farzonl/gtnr/README.md

# The Repo of the Georgia Tech Night Rover Project
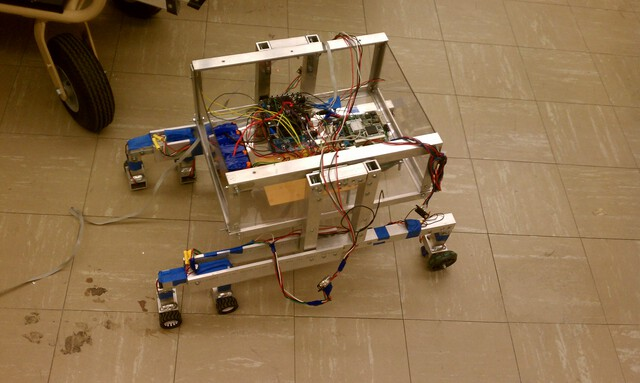
[picture p1: Documentation/SharedImages/IMAG1715.jpg]

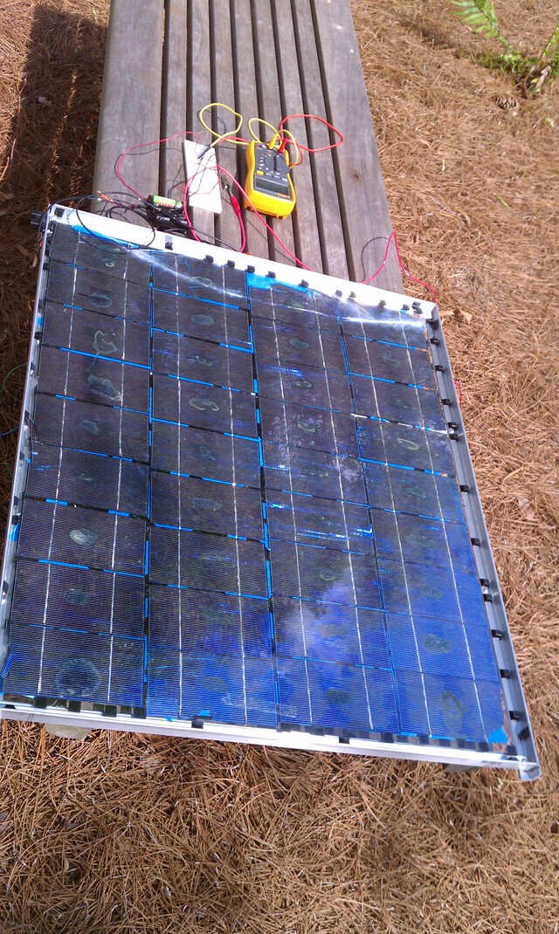
[picture p2: Documentation/SharedImages/IMAG1690.jpg]


## Proposal:
<object data="https://raw.githubusercontent.com/farzonl/gtnr/master/Documentation/Proposals/GT_NightRover-CornellCupApplication_v2.pdf" type="application/pdf" width="700px" height="700px">
    <p>Github does not support embedded PDFs. <a href="https://raw.githubusercontent.com/farzonl/gtnr/master/Documentation/Proposals/GT_NightRover-CornellCupApplication_v2.pdf"> Click here to view</a>.</p>
</object>

## Solar Panel Monte Carlo Simulations
### Power Output Distribution
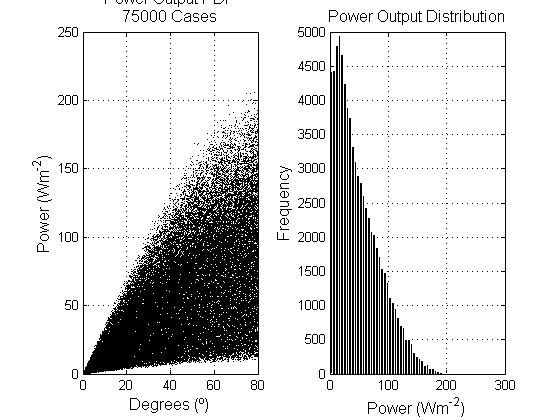
[picture p3: MATLAB/SolarPanelMonteCarlo/PowerOutputDistribution.png]

### Power Output (PDF & CDF)
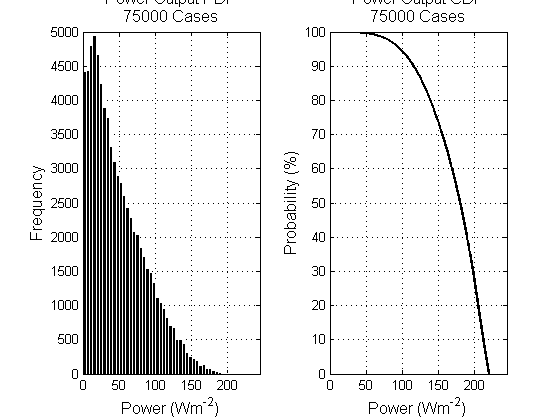
[picture p4: MATLAB/SolarPanelMonteCarlo/PowerOutputPDFCDF.png]

### Random Variable Distribution
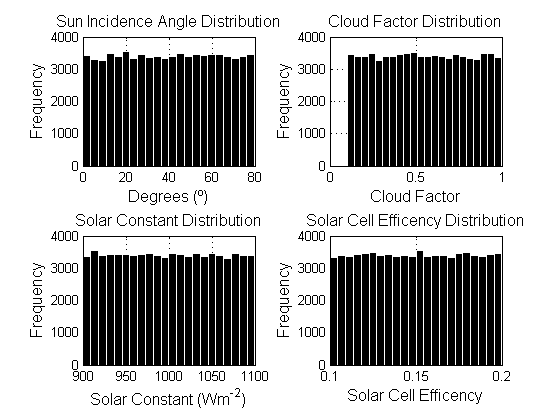
[picture p5: MATLAB/SolarPanelMonteCarlo/RandomVariableDistribution-1.png]

### Random Variable Distribution 2
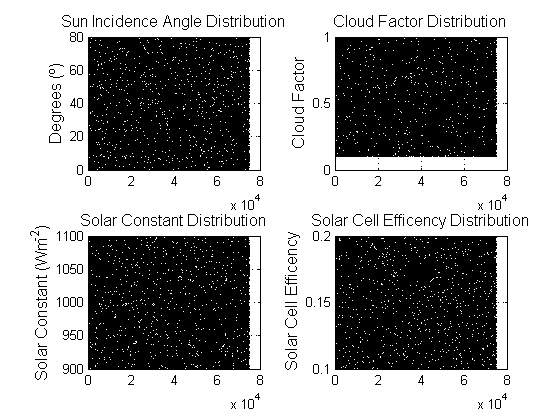
[picture p6: MATLAB/SolarPanelMonteCarlo/RandomVariableDistribution-2.png]


## Electrical Overview
### Schematic
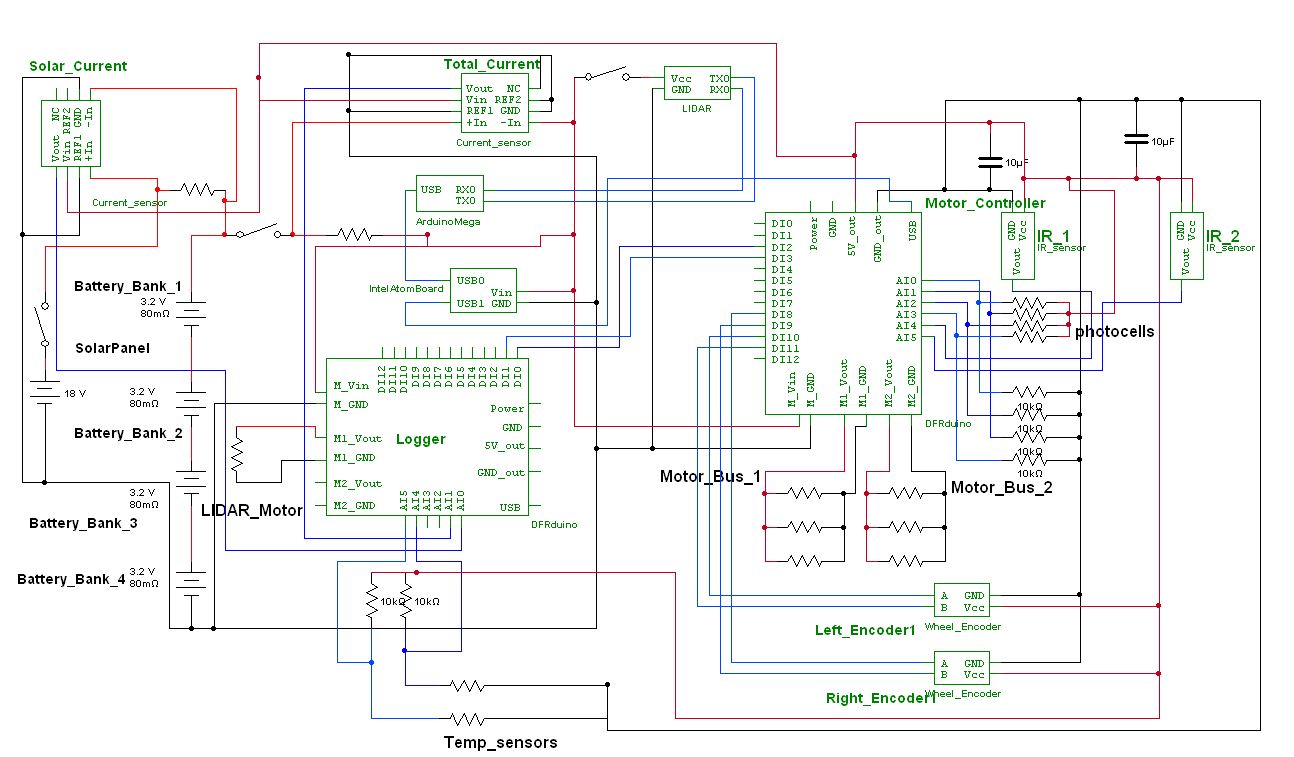
[picture p7: Documentation/FinalReport/schematic4.JPG]


## Software Overview
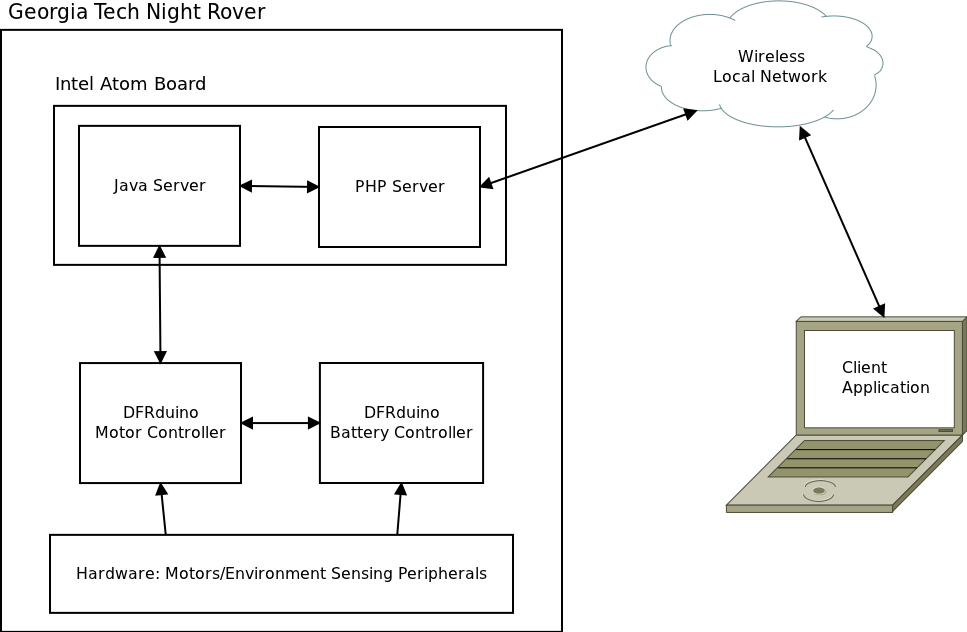
[picture p8: Documentation/FinalReport/SoftwareArchitecture/SoftwareOverview.png]

### Website
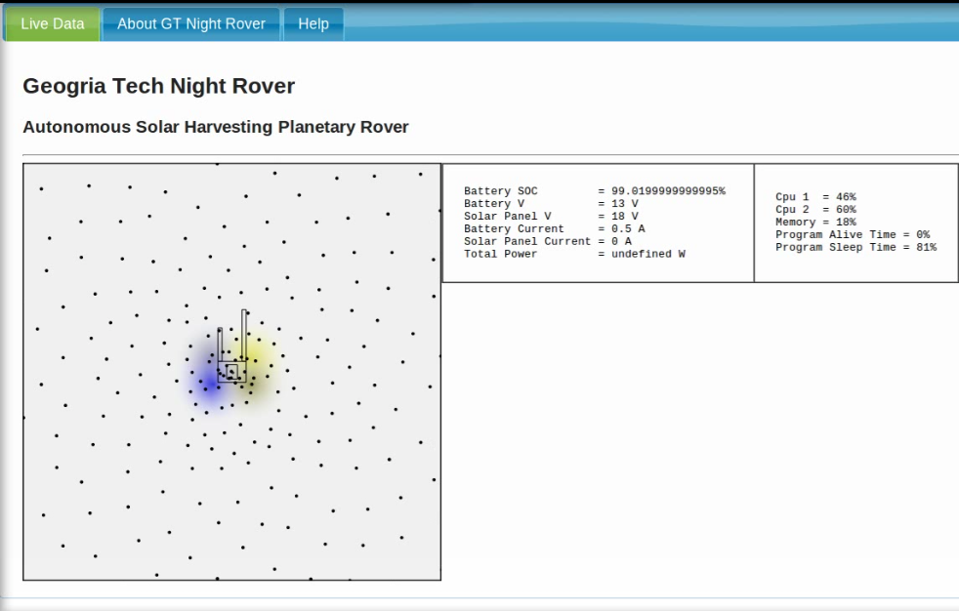
[picture p9: Documentation/FinalReport/GTNR_site.png]

### UML (Overview)
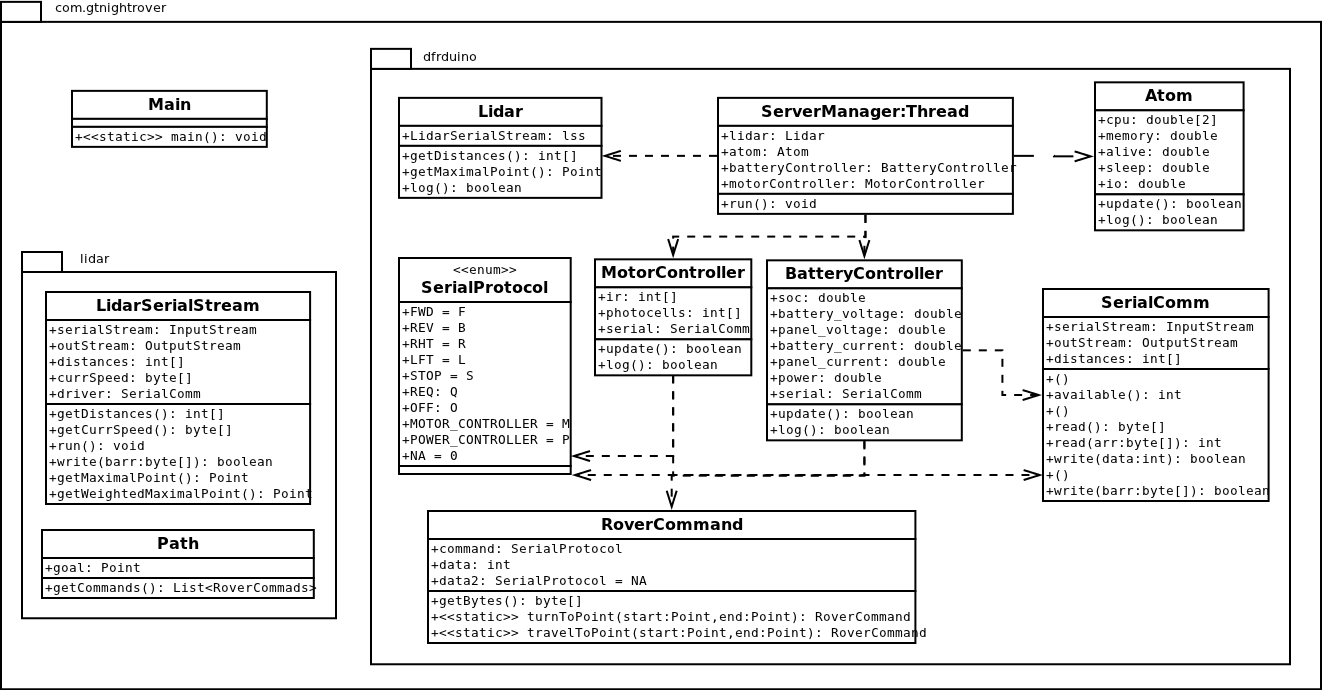
[picture p10: Documentation/FinalReport/SoftwareArchitecture/GTNR_UML.png]

### UML (deep dive)
#### lidar
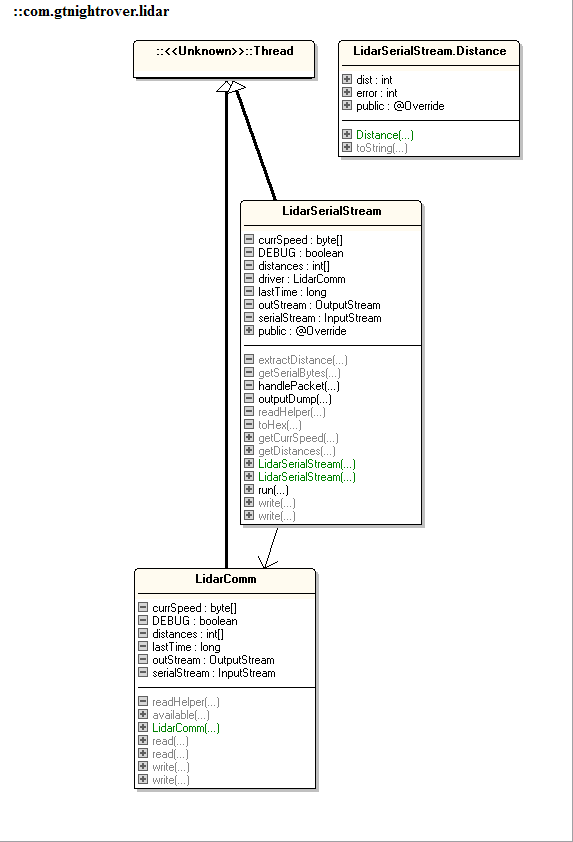
[picture p11: Documentation/FinalReport/SoftwareArchitecture/lidar.png]

#### log
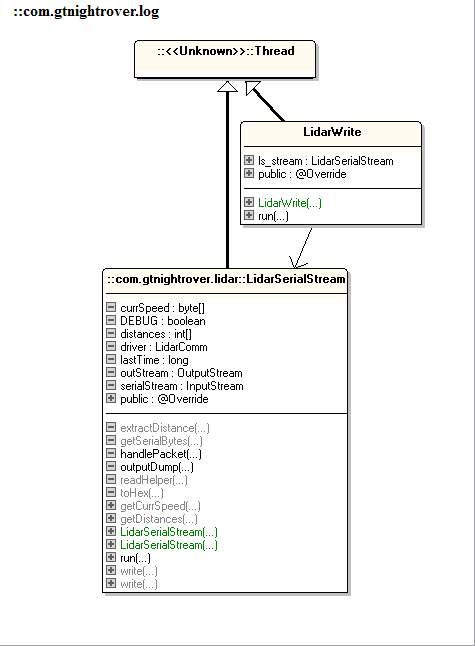
[picture p12: Documentation/FinalReport/SoftwareArchitecture/log.png]

#### Networking
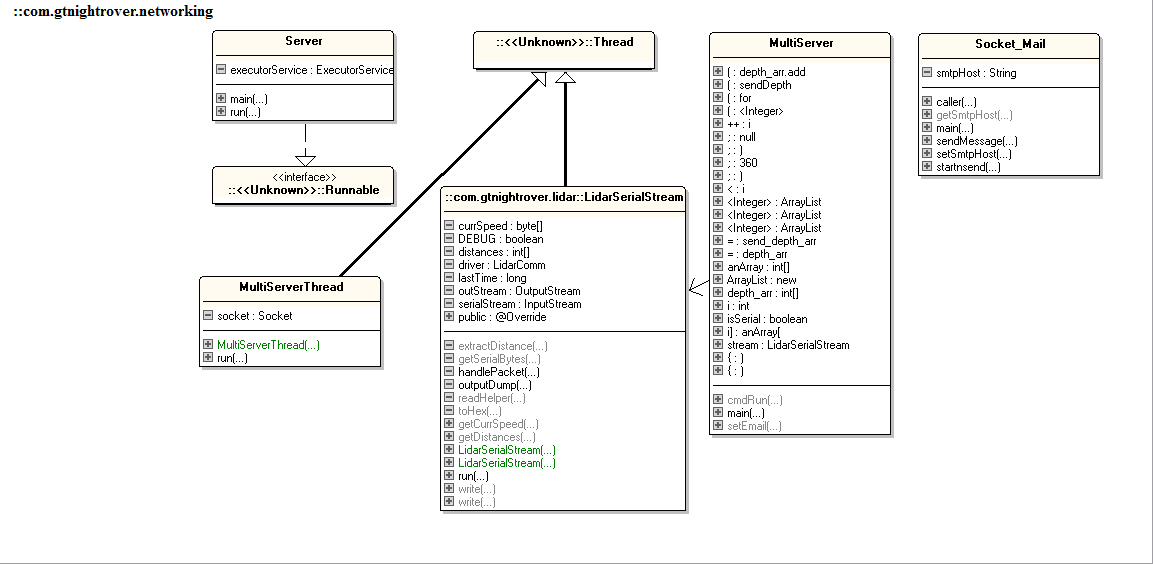
[picture p13: Documentation/FinalReport/SoftwareArchitecture/Networking.png]

#### Serial
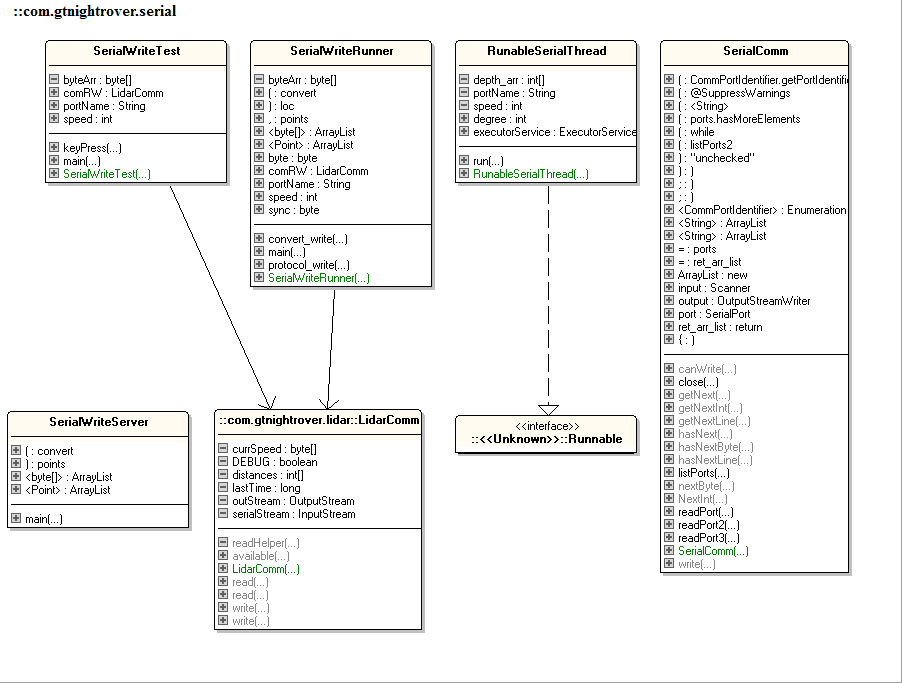
[picture p14: Documentation/FinalReport/SoftwareArchitecture/Serial.png]

#### Graph Search
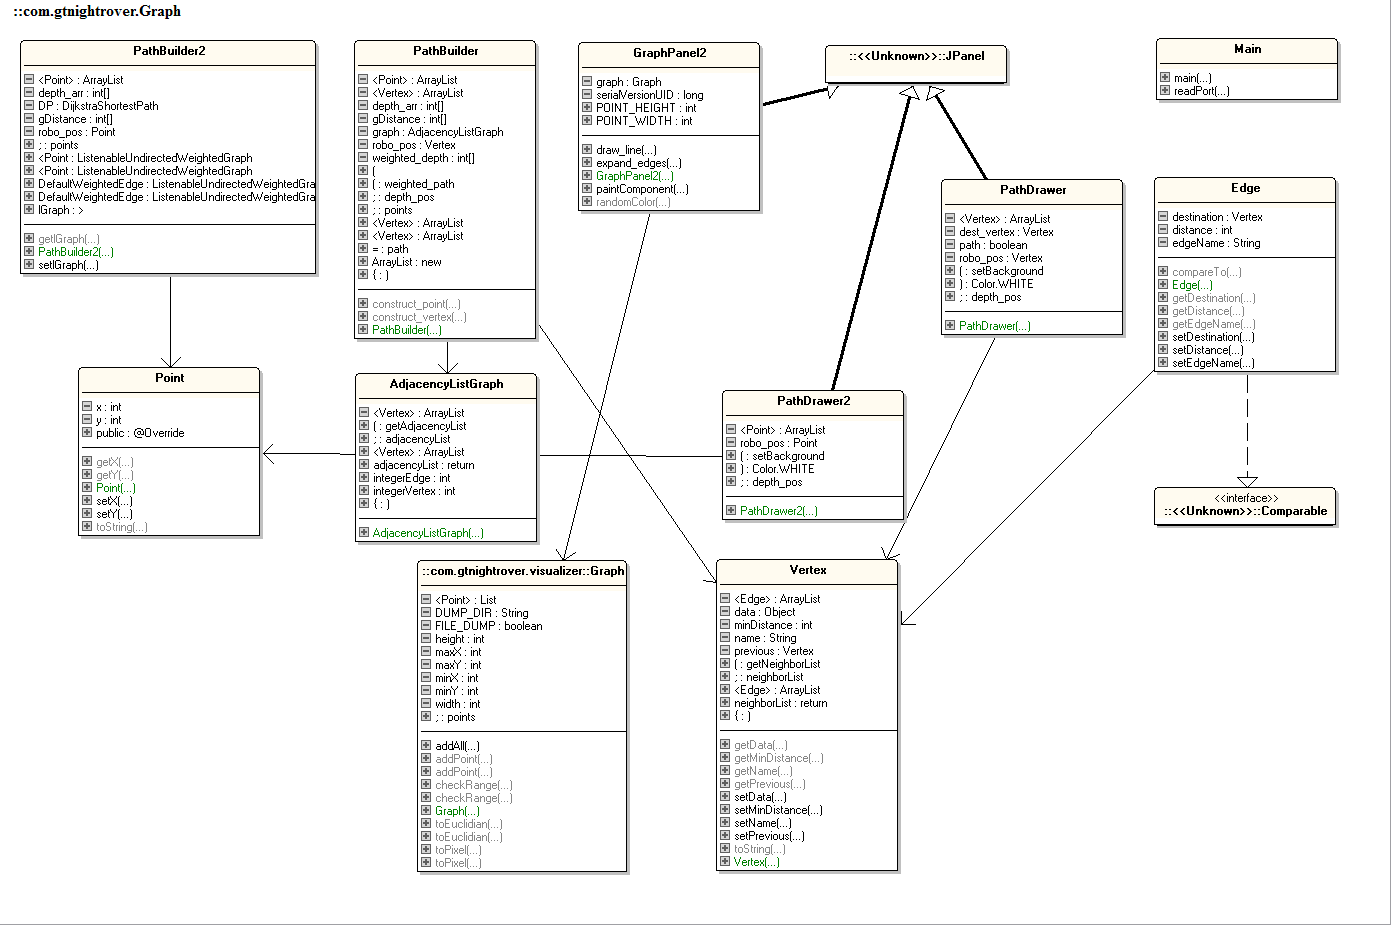
[picture p15: Documentation/FinalReport/SoftwareArchitecture/graph.png]


## Mechanical Overview
<object data="https://raw.githubusercontent.com/farzonl/gtnr/master/Documentation/FinalReport/StructureCAD/rockerDrawings.PDF" type="application/pdf" width="700px" height="700px">
    <p>Github does not support embedded PDFs. <a href="https://raw.githubusercontent.com/farzonl/gtnr/master/Documentation/FinalReport/StructureCAD/rockerDrawings.PDF"> Click here to view</a>.</p>
</object>

## Lidar demonstration:
- https://youtu.be/Fa6pLtnfDQM
- https://youtu.be/SGN1jOzPnew

## Presentations
### Midterm Review
<object data="https://raw.githubusercontent.com/farzonl/gtnr/master/Documentation/Presentations/GTNR_MidTermReview2.pdf" type="application/pdf" width="700px" height="700px">
    <p>Github does not support embedded PDFs. <a href="https://raw.githubusercontent.com/farzonl/gtnr/master/Documentation/Presentations/GTNR_MidTermReview2.pdf"> Click here to view</a>.</p>
</object>

### Final Review
<object data="https://raw.githubusercontent.com/farzonl/gtnr/master/Documentation/Presentations/GTNR_Final_Presentation.pdf" type="application/pdf" width="700px" height="700px">
    <p>Github does not support embedded PDFs. <a href="https://raw.githubusercontent.com/farzonl/gtnr/master/Documentation/Presentations/GTNR_Final_Presentation.pdf"> Click here to view</a>.</p>
</object>

## Final report:
<object data="https://raw.githubusercontent.com/farzonl/gtnr/master/Documentation/FinalReport/ICCFinalReport_2.pdf" type="application/pdf" width="700px" height="700px">
    <p>Github does not support embedded PDFs. <a href="https://raw.githubusercontent.com/farzonl/gtnr/master/Documentation/FinalReport/ICCFinalReport_2.pdf"> Click here to view</a>.</p>
</object>
