farzonl/gtnr/Documentation/FinalReport/StructureCAD/Mechanical/Lunar Rover Config 1.pptx

Solar Panel

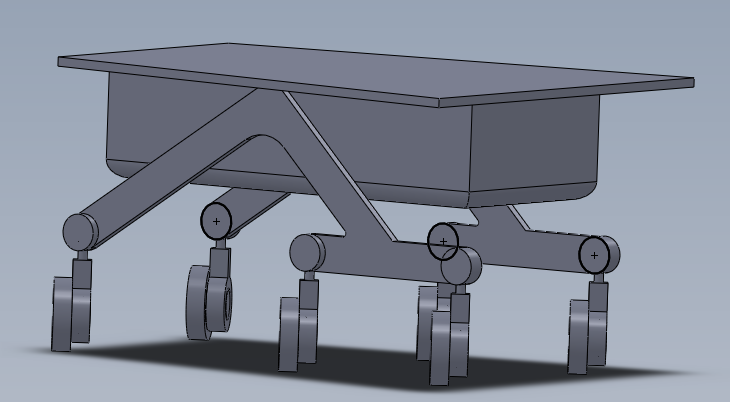
[picture p50: figure]

Body
(Houses avonics)

Roller Bearing for pivoting joints
