farzonl/gtnr/Documentation/FinalReport/MotorCalculations.xls

Sheet: 0 Degrees
 | Posted Experimental Torque On Flat Ground
 |  |  |  | Torque (kgm^2/s^2)
These values are calculated using T=maL, where "m" is mass, "a" is acceleration (0.5m/s^2) and "L" is length. |  | Mass (kg) | Wheel Size (m) | needed | diff | provided | Force (kgm/s^2) | # Motors
 |  | 6 | 0.044 |  |  |  | 0.0706 | 6
 |  | 8 | 0.044 |  |  |  | 0.0706 | 6
 |  | 10 | 0.044 |  |  |  | 0.0706 | 6
 |  | 12 | 0.044 |  |  |  | 0.0706 | 6
 |  | 15 | 0.044 |  |  |  | 0.0706 | 6
 |  | 6 | 0.044 |  |  |  | 0.0706 | 8
 |  | 8 | 0.044 |  |  |  | 0.0706 | 8
 |  | 10 | 0.044 |  |  |  | 0.0706 | 8
 |  | 12 | 0.044 |  |  |  | 0.0706 | 8
 |  | 15 | 0.044 |  |  |  | 0.0706 | 8
 |  | 20 | 0.044 |  |  |  | 0.0706 | 8
 |  | 6 | 0.06 |  |  |  | 0.0706 | 6
 |  | 8 | 0.06 |  |  |  | 0.0706 | 6
 |  | 10 | 0.06 |  |  |  | 0.0706 | 6
 |  | 12 | 0.06 |  |  |  | 0.0706 | 6
 |  | 15 | 0.06 |  |  |  | 0.0706 | 6
 |  | 15 | 0.06 |  |  |  | 0.0706 | 6
 |  | 6 | 0.06 |  |  |  | 0.0706 | 8
 |  | 8 | 0.06 |  |  |  | 0.0706 | 8
 |  | 10 | 0.06 |  |  |  | 0.0706 | 8
 |  | 12 | 0.06 |  |  |  | 0.0706 | 8
 |  | 15 | 0.06 |  |  |  | 0.0706 | 8
 |  | 20 | 0.06 |  |  |  | 0.0706 | 8
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
