farzonl/gtnr/Documentation/FinalReport/Electrical/BatteryDesign/pic1.JPG

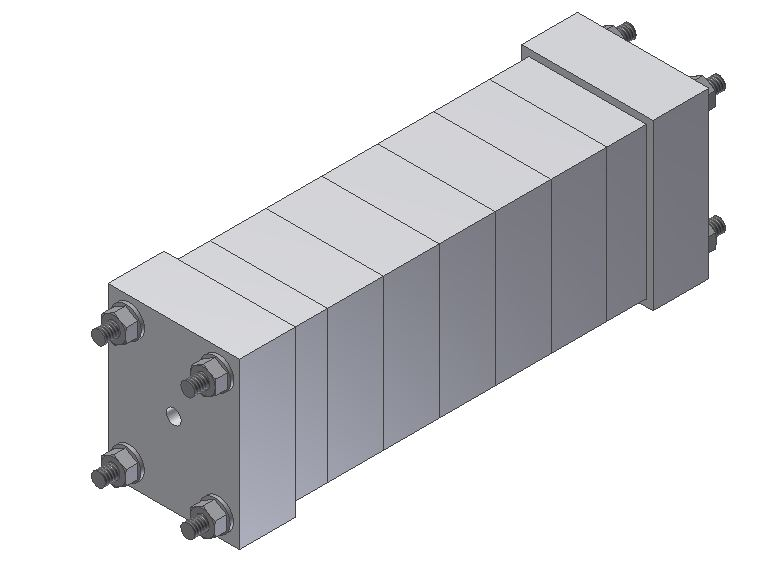
Documentation/FinalReport/Electrical/BatteryDesign/pic1.JPG
