farzonl/gtnr/Documentation/FinalReport/Electrical/BatteryDesign/pic2.JPG

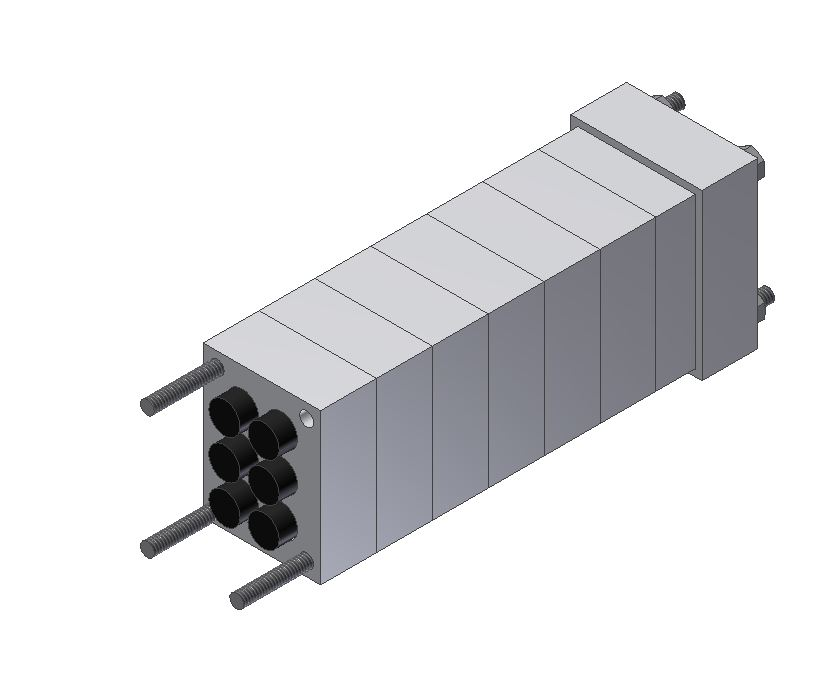
Documentation/FinalReport/Electrical/BatteryDesign/pic2.JPG
