farzonl/gtnr/Documentation/FinalReport/Electrical/BatteryDesign/pic3.JPG

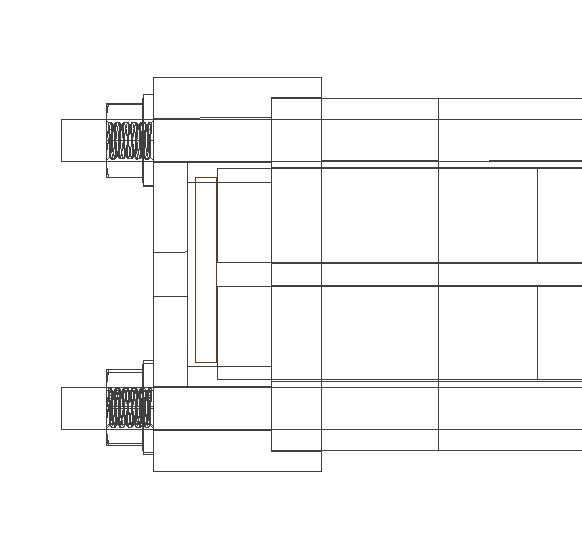
Documentation/FinalReport/Electrical/BatteryDesign/pic3.JPG
