farzonl/gtnr/Documentation/FinalReport/Electrical/BatteryDesign/pic4.JPG

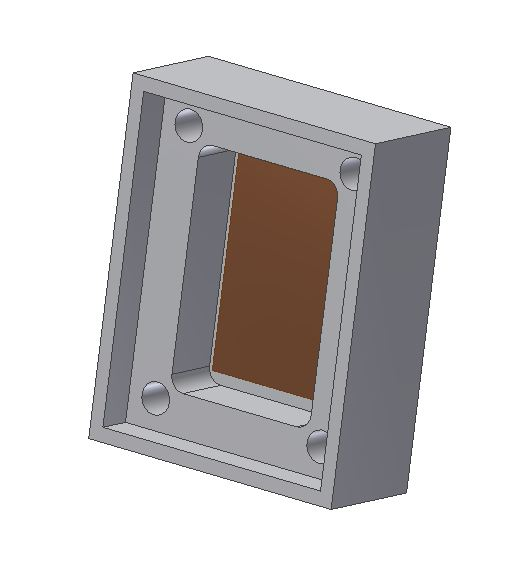
Documentation/FinalReport/Electrical/BatteryDesign/pic4.JPG
