farzonl/gtnr/Documentation/FinalReport/Electrical/SubsystemsDiagramv1.png

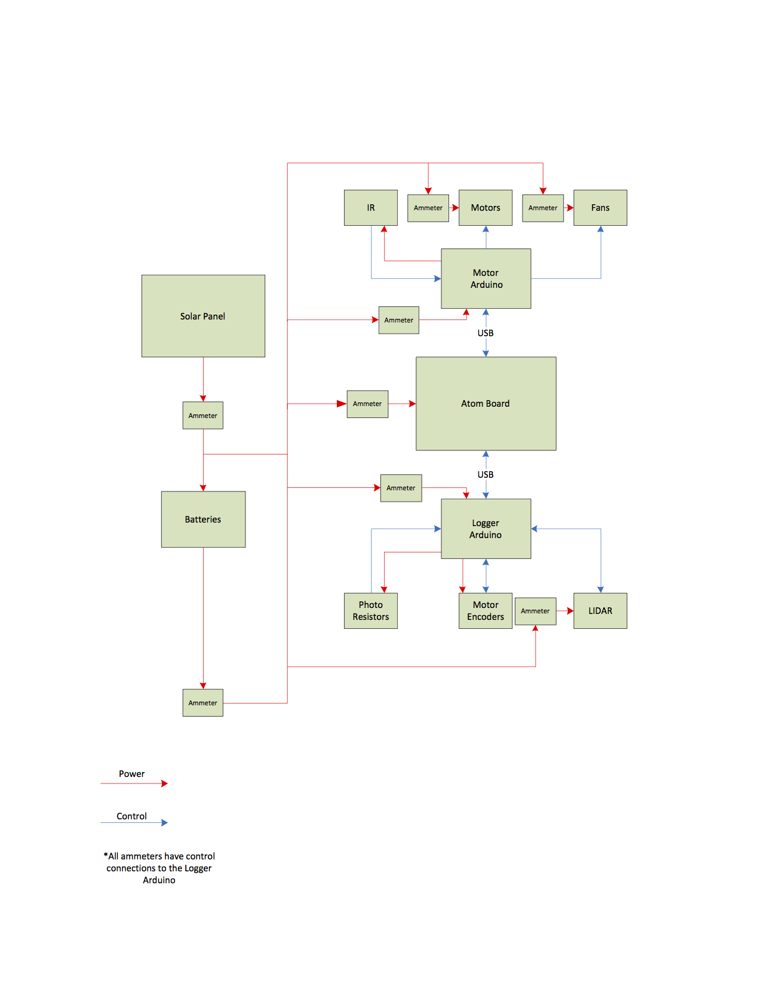
Documentation/FinalReport/Electrical/SubsystemsDiagramv1.png
