farzonl/gtnr/Documentation/FinalReport/SoftwareArchitecture/visualizer.png

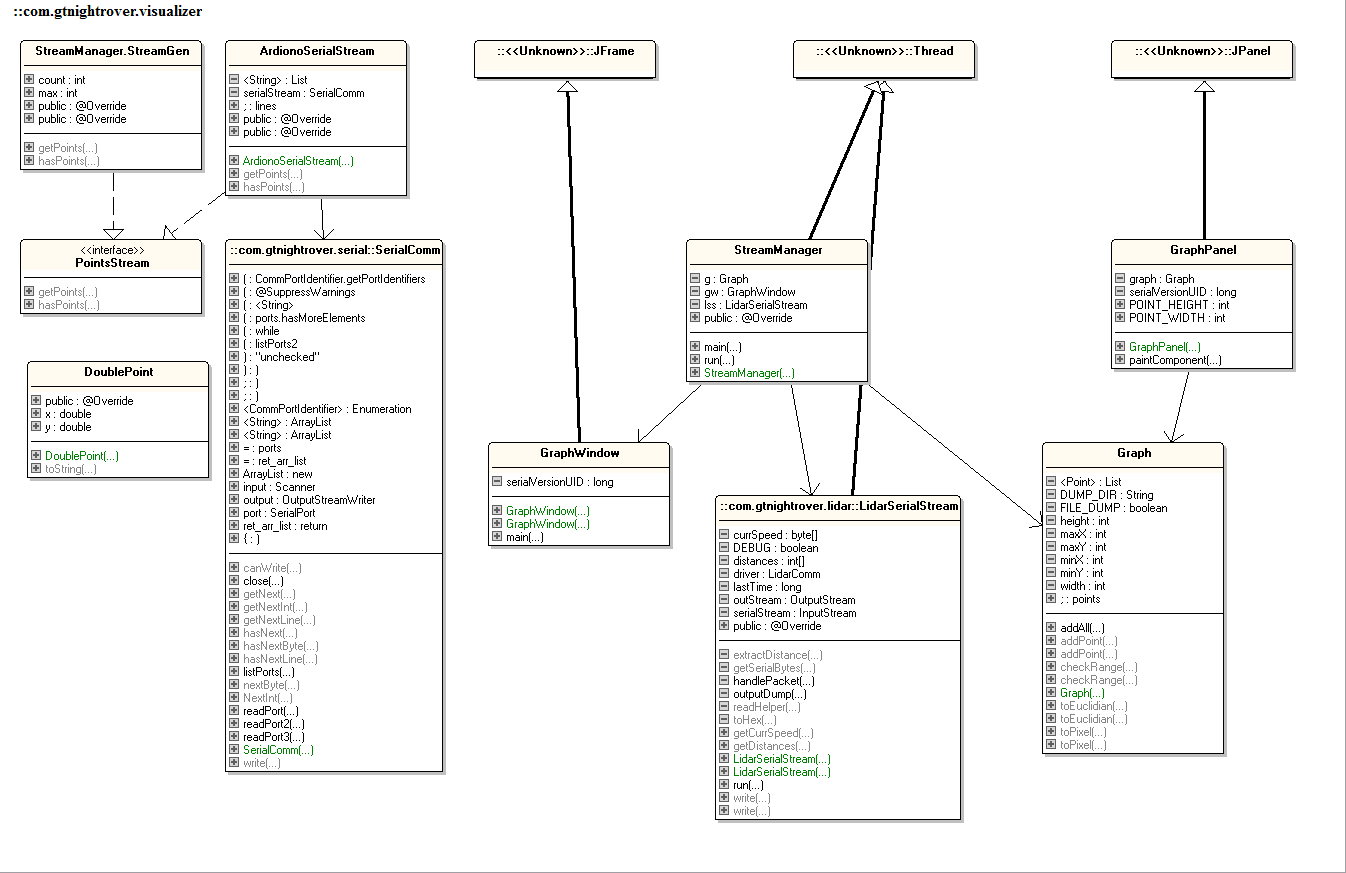
Documentation/FinalReport/SoftwareArchitecture/visualizer.png
