farzonl/gtnr/Documentation/FinalReport/StructureCAD/Mechanical/DesignSpecs.png

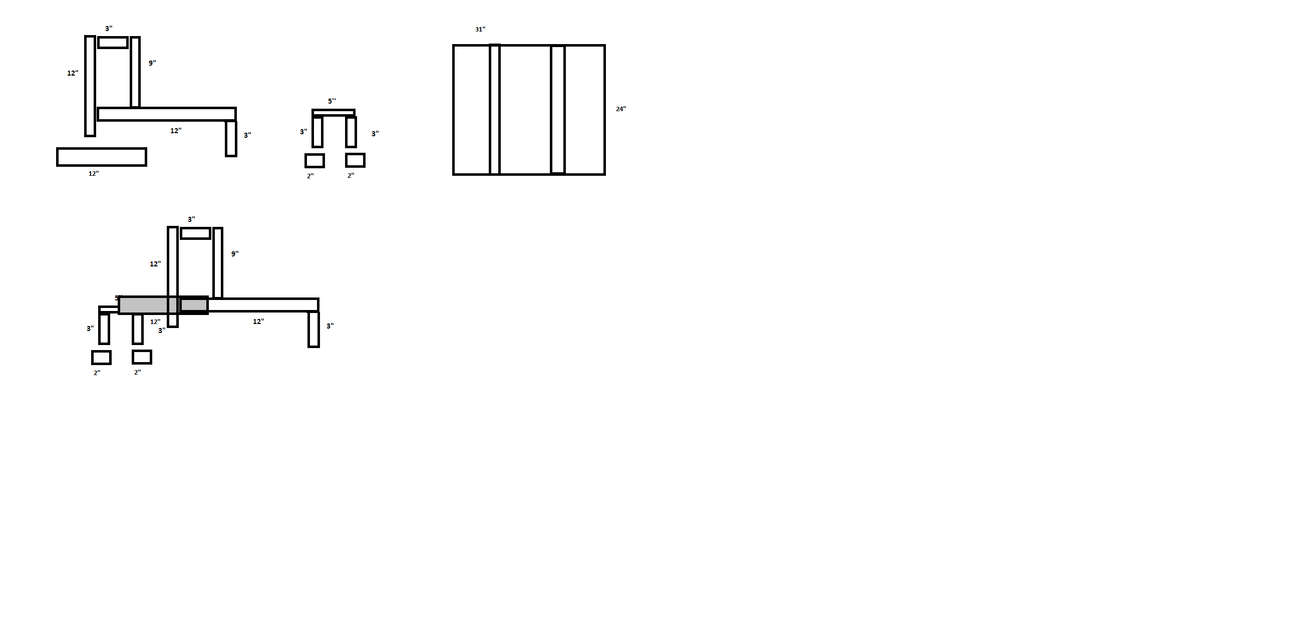
Documentation/FinalReport/StructureCAD/Mechanical/DesignSpecs.png
