farzonl/gtnr/Documentation/FinalReport/StructureCAD/Mechanical/LayoutProposalv1.png

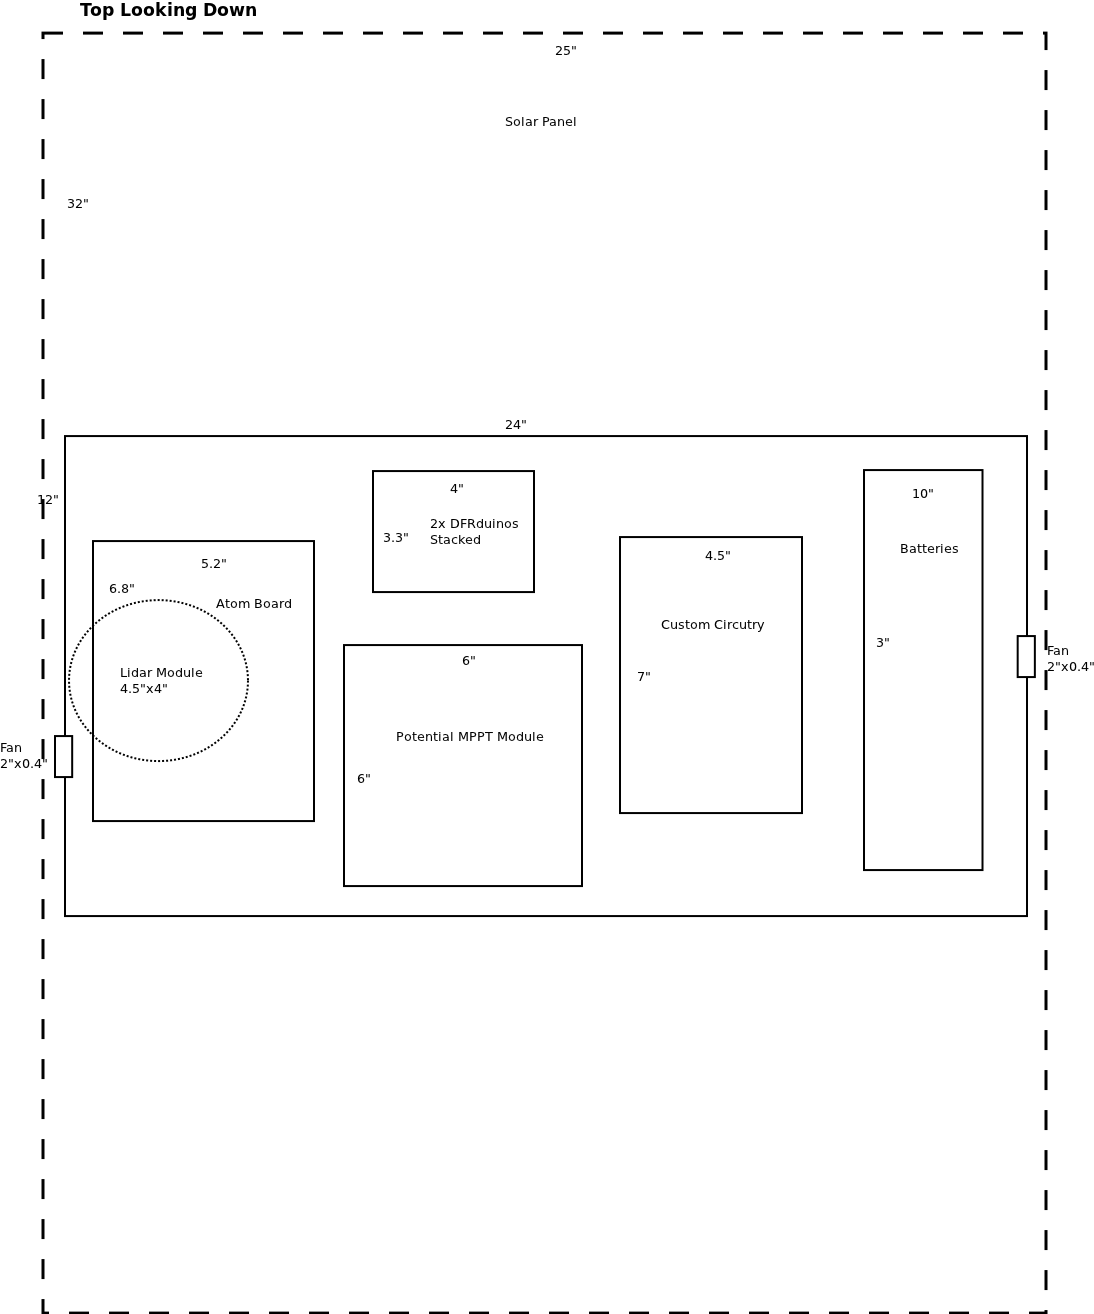
Documentation/FinalReport/StructureCAD/Mechanical/LayoutProposalv1.png
