farzonl/gtnr/Documentation/FinalReport/StructureCAD/Mechanical/rockerDrawings.JPG

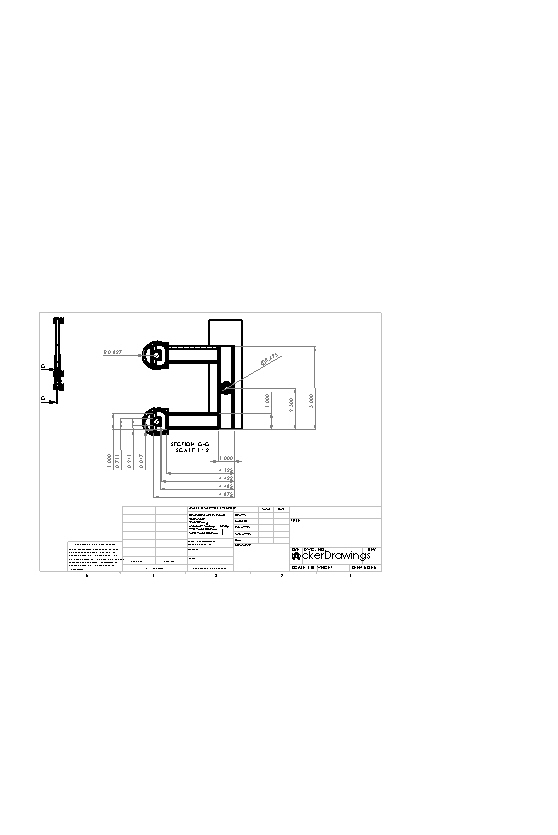
Documentation/FinalReport/StructureCAD/Mechanical/rockerDrawings.JPG
