farzonl/gtnr/Documentation/FinalReport/StructureCAD/ScreenCapDrawings.PNG

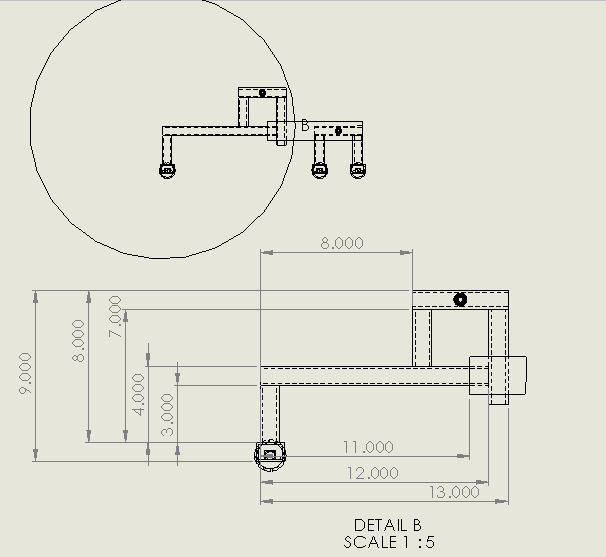
Documentation/FinalReport/StructureCAD/ScreenCapDrawings.PNG
