farzonl/gtnr/Documentation/SharedImages/2012-01-21 16.25.33.jpg

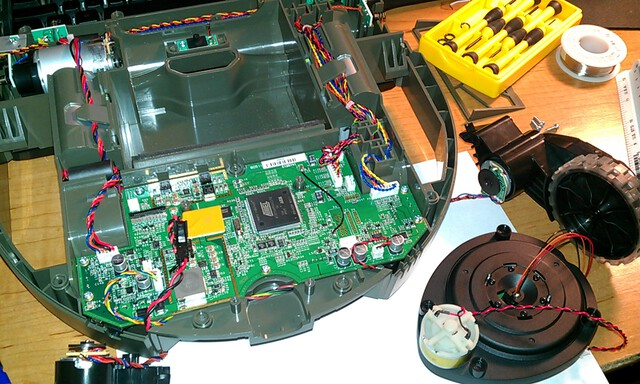
Documentation/SharedImages/2012-01-21 16.25.33.jpg
