farzonl/gtnr/Documentation/SharedImages/2012-01-21 16.57.16.jpg

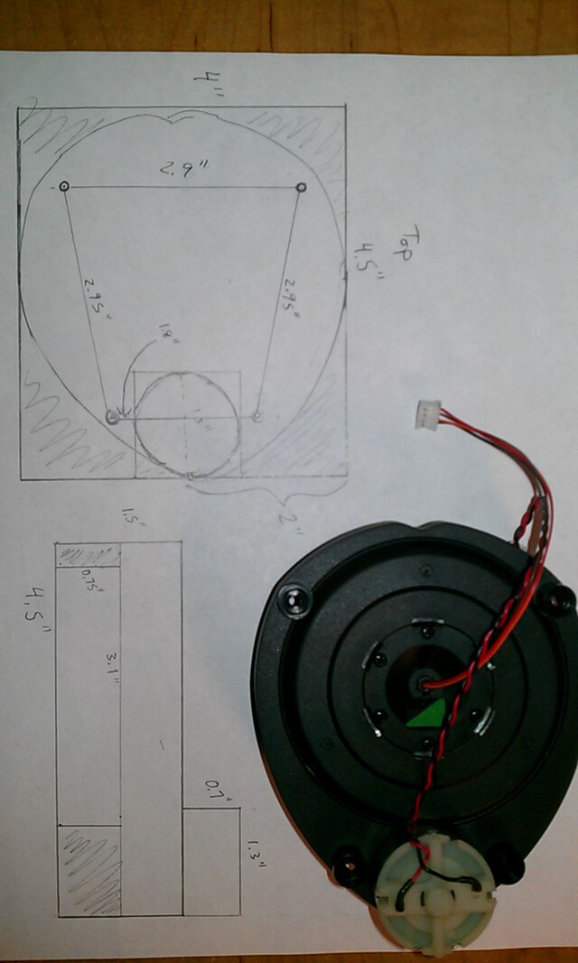
Documentation/SharedImages/2012-01-21 16.57.16.jpg
