farzonl/gtnr/Documentation/SharedImages/2012-01-21 16.57.35.jpg

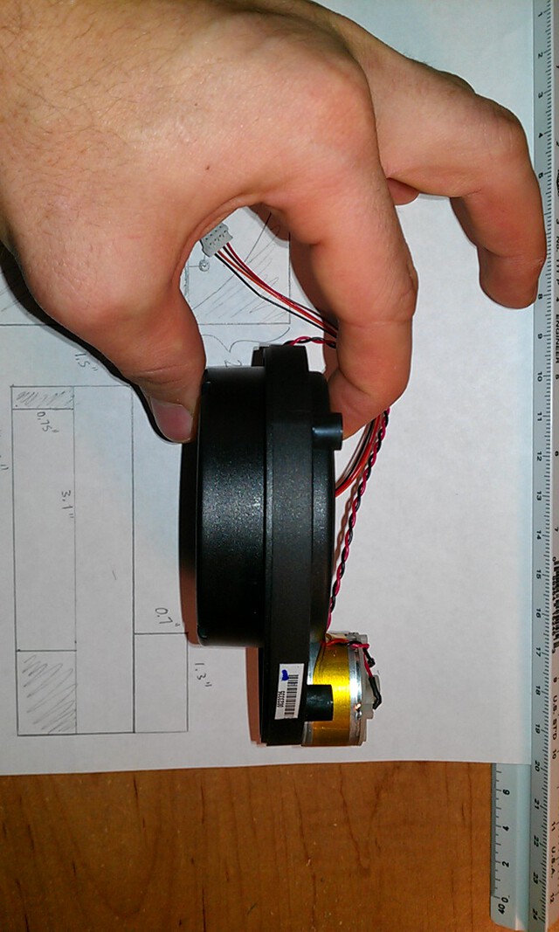
Documentation/SharedImages/2012-01-21 16.57.35.jpg
