farzonl/gtnr/Documentation/SharedImages/2012-01-21 17.38.47.jpg

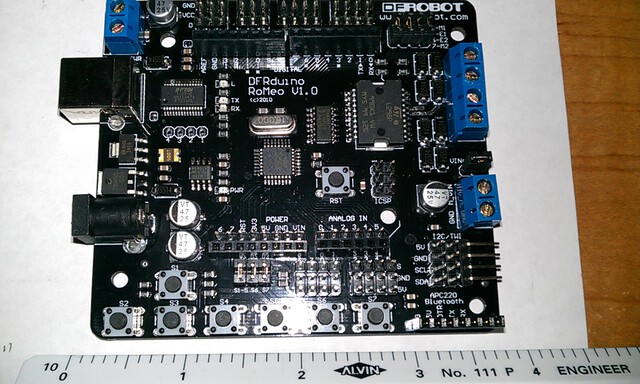
Documentation/SharedImages/2012-01-21 17.38.47.jpg
