farzonl/gtnr/Documentation/SharedImages/2012-01-21 17.39.13.jpg

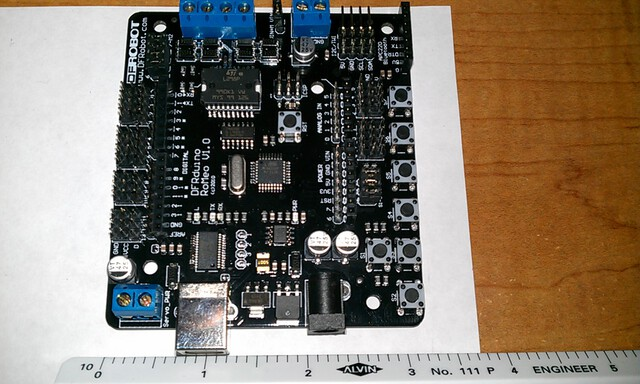
Documentation/SharedImages/2012-01-21 17.39.13.jpg
