farzonl/gtnr/Documentation/SharedImages/2012-01-21 17.40.02.jpg

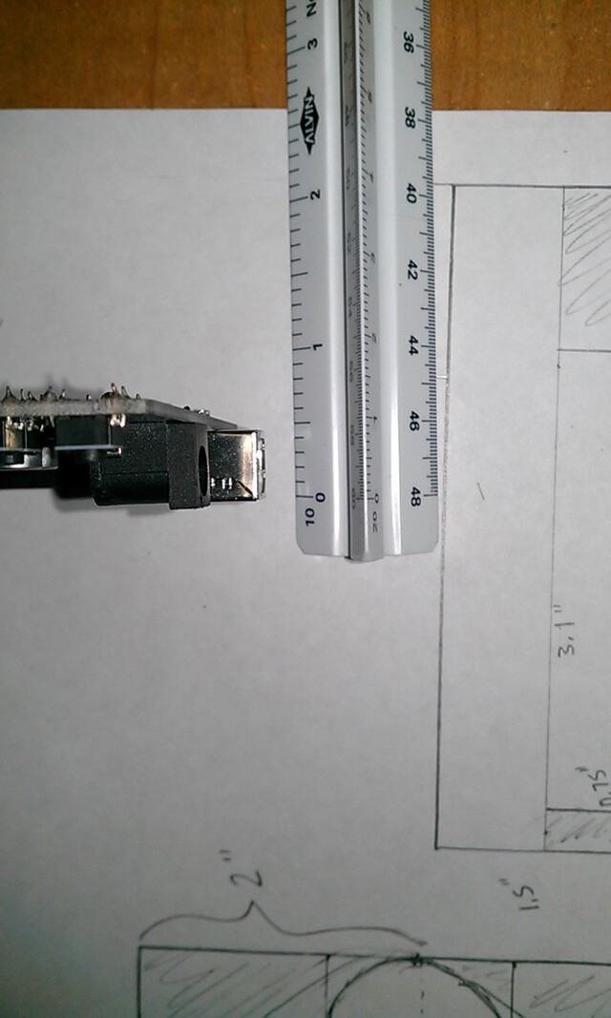
Documentation/SharedImages/2012-01-21 17.40.02.jpg
