farzonl/gtnr/Documentation/SharedImages/2012-01-26 22.44.55.jpg

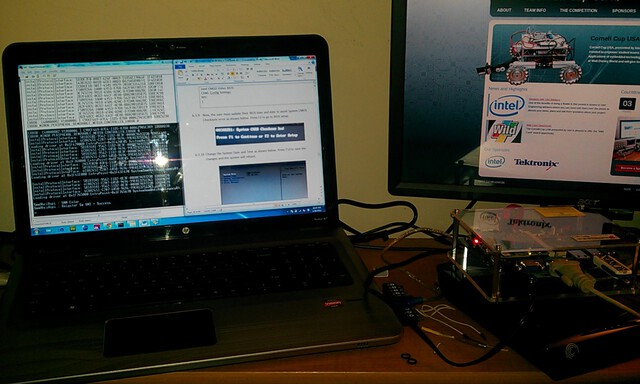
Documentation/SharedImages/2012-01-26 22.44.55.jpg
