farzonl/gtnr/Documentation/SharedImages/2012-01-26 22.45.20.jpg

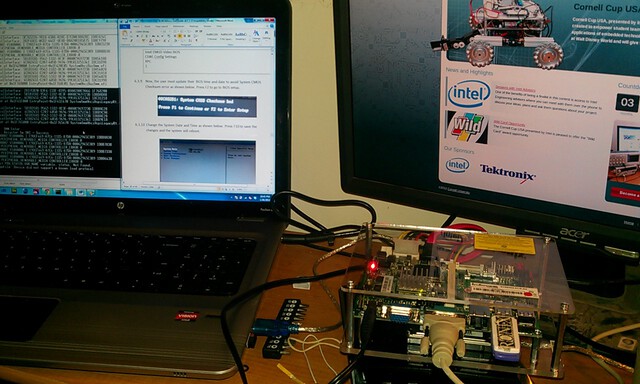
Documentation/SharedImages/2012-01-26 22.45.20.jpg
