farzonl/gtnr/Documentation/SharedImages/2012-01-26 22.59.47.jpg

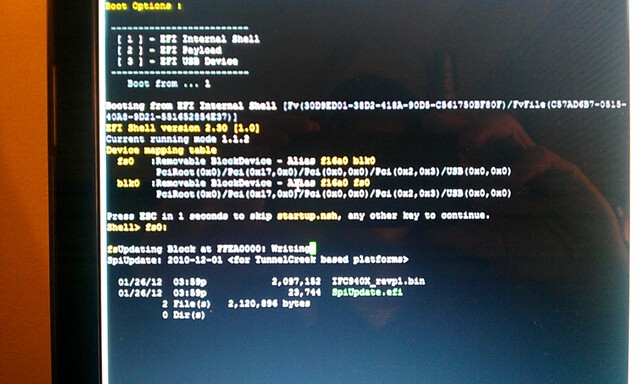
Documentation/SharedImages/2012-01-26 22.59.47.jpg
