farzonl/gtnr/Documentation/SharedImages/2012-01-26 23.00.48.jpg

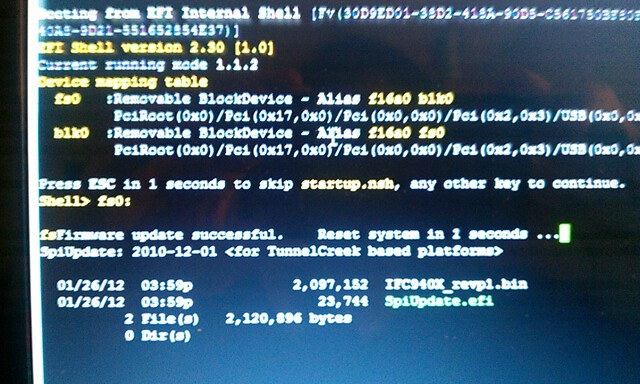
Documentation/SharedImages/2012-01-26 23.00.48.jpg
