farzonl/gtnr/Documentation/SharedImages/2012-01-26 23.04.52.jpg

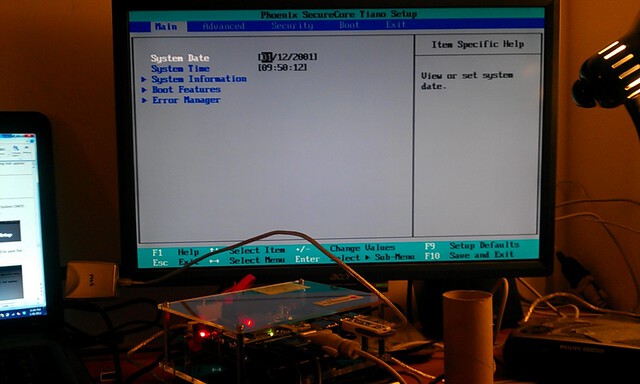
Documentation/SharedImages/2012-01-26 23.04.52.jpg
