farzonl/gtnr/Documentation/SharedImages/2012-01-26 23.05.12.jpg

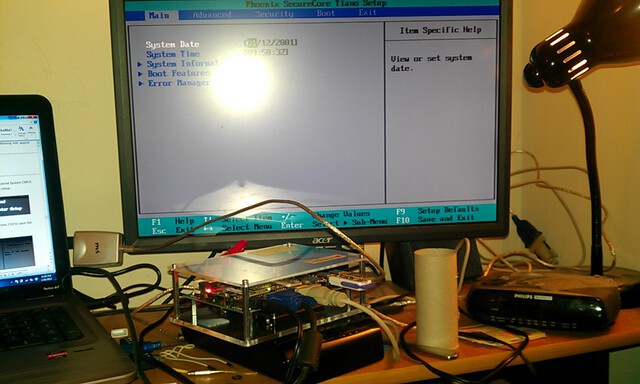
Documentation/SharedImages/2012-01-26 23.05.12.jpg
