farzonl/gtnr/Documentation/SharedImages/2012-01-26 23.07.22.jpg

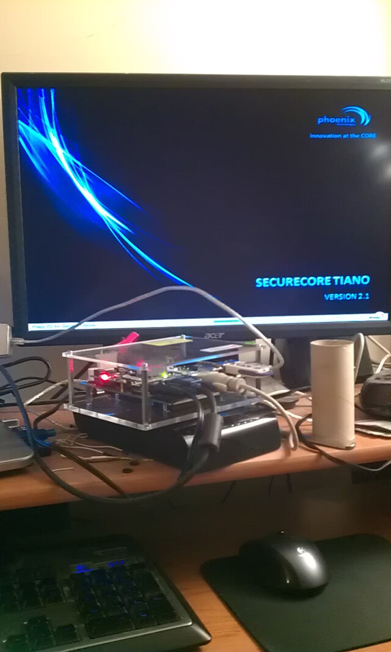
Documentation/SharedImages/2012-01-26 23.07.22.jpg
