farzonl/gtnr/Documentation/SharedImages/2012-01-27 00.06.14.jpg

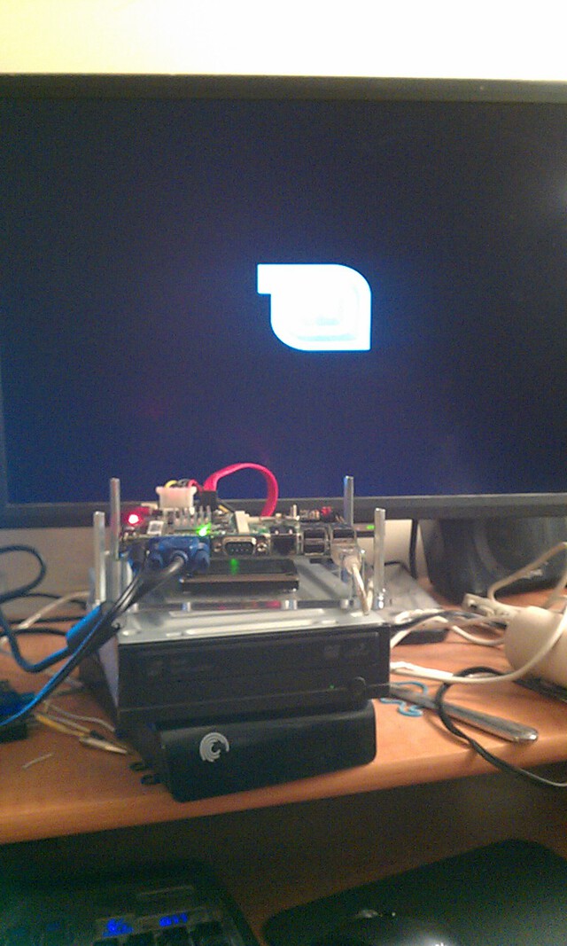
Documentation/SharedImages/2012-01-27 00.06.14.jpg
