farzonl/gtnr/Documentation/SharedImages/2012-01-27 00.06.26.jpg

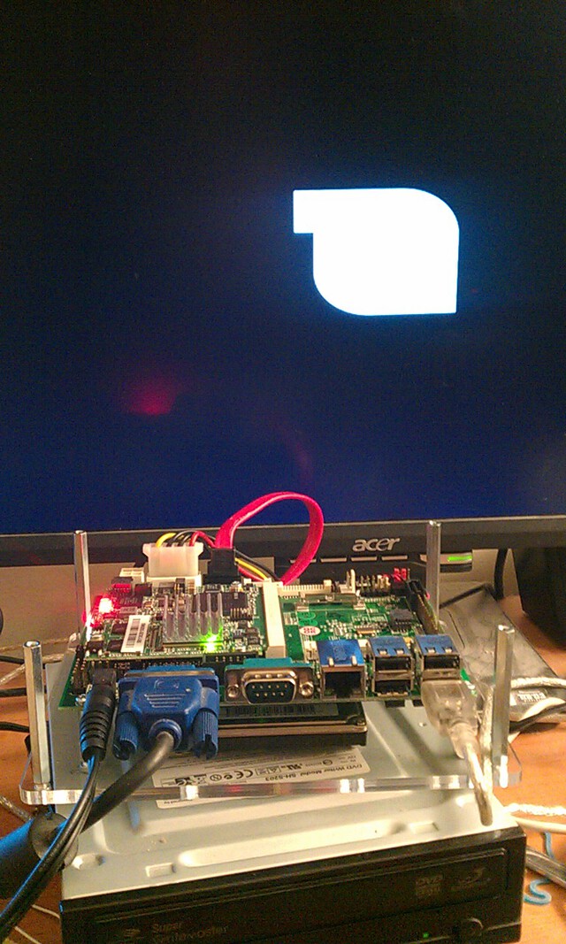
Documentation/SharedImages/2012-01-27 00.06.26.jpg
