farzonl/gtnr/Documentation/SharedImages/2012-01-27 00.07.05.jpg

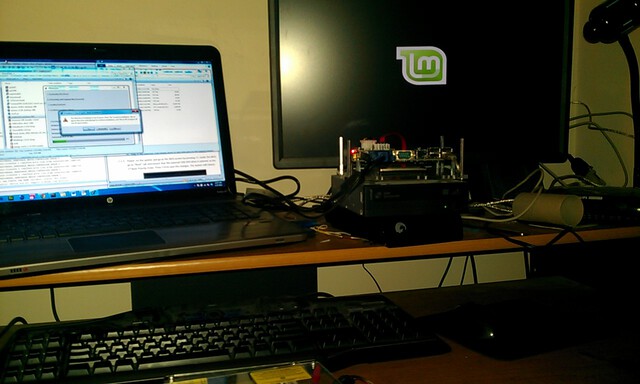
Documentation/SharedImages/2012-01-27 00.07.05.jpg
