farzonl/gtnr/Documentation/SharedImages/2012-01-27 00.18.57.jpg

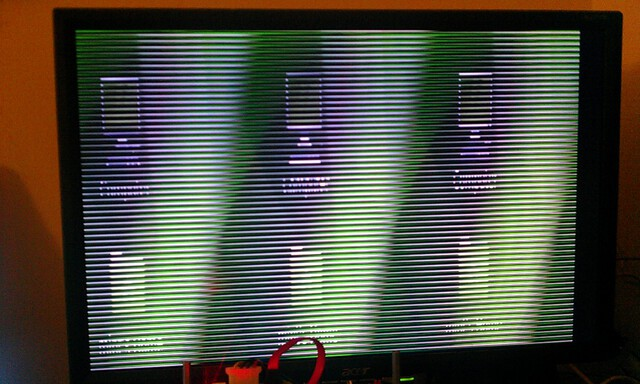
Documentation/SharedImages/2012-01-27 00.18.57.jpg
