farzonl/gtnr/Documentation/SharedImages/2012-01-27 01.10.22.jpg

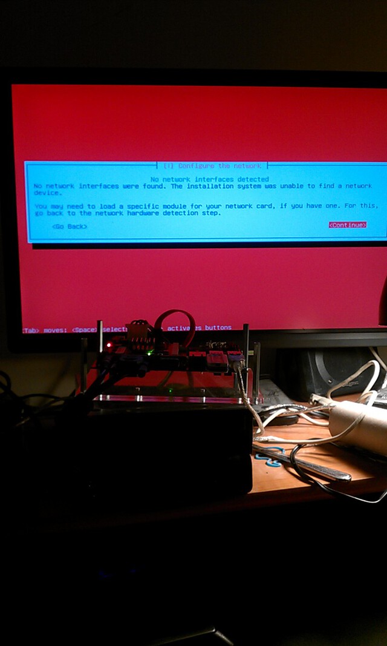
Documentation/SharedImages/2012-01-27 01.10.22.jpg
