farzonl/gtnr/Documentation/SharedImages/2012-01-27 01.13.01.jpg

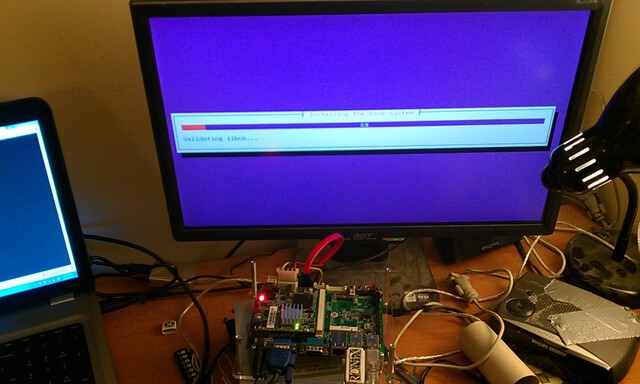
Documentation/SharedImages/2012-01-27 01.13.01.jpg
