farzonl/gtnr/Documentation/SharedImages/2012-01-27 01.13.12.jpg

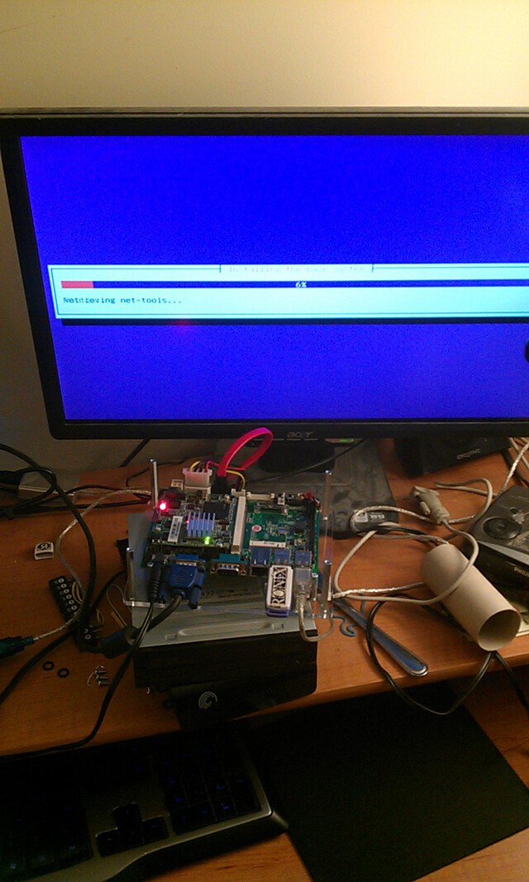
Documentation/SharedImages/2012-01-27 01.13.12.jpg
