farzonl/gtnr/Documentation/SharedImages/2012-01-27 01.19.35.jpg

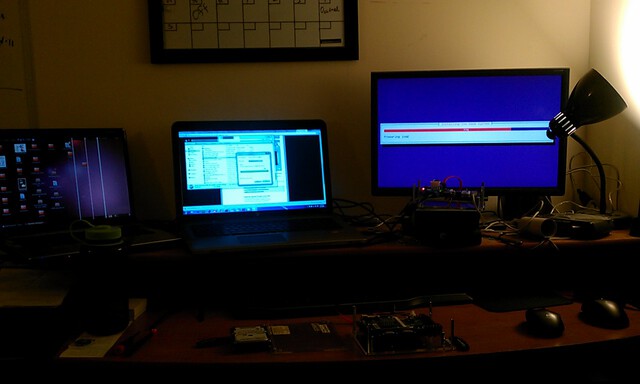
Documentation/SharedImages/2012-01-27 01.19.35.jpg
