farzonl/gtnr/Documentation/SharedImages/2012-01-27 01.19.46.jpg

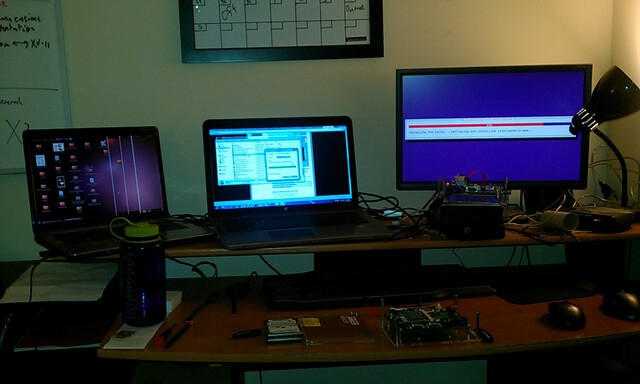
Documentation/SharedImages/2012-01-27 01.19.46.jpg
