farzonl/gtnr/Documentation/SharedImages/2012-01-27 01.40.11.jpg

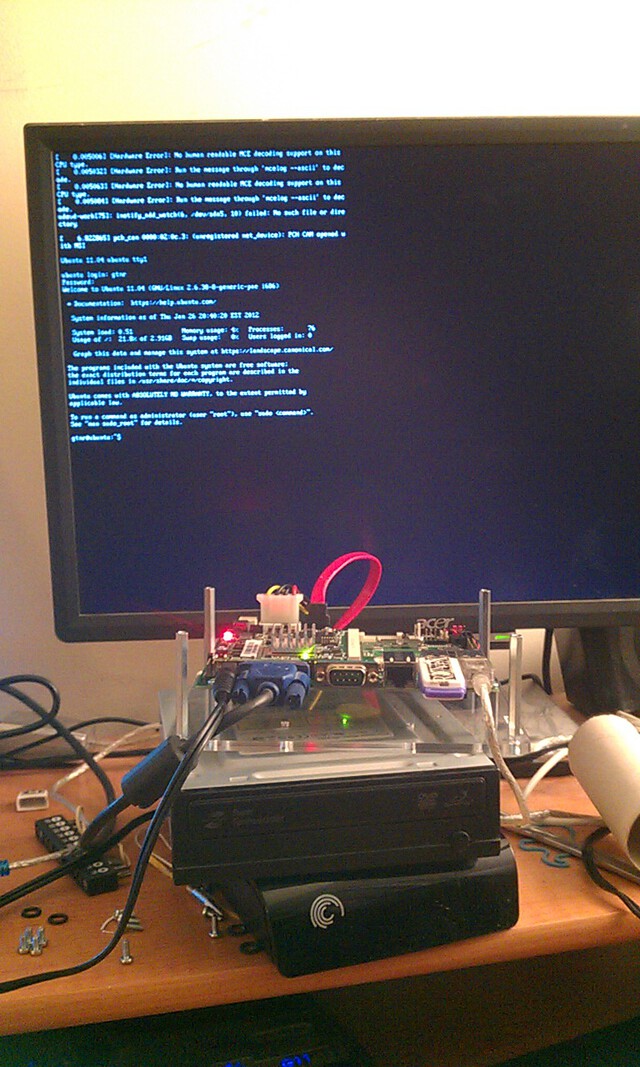
Documentation/SharedImages/2012-01-27 01.40.11.jpg
