farzonl/gtnr/Documentation/SharedImages/2012-02-11 13.01.28.jpg

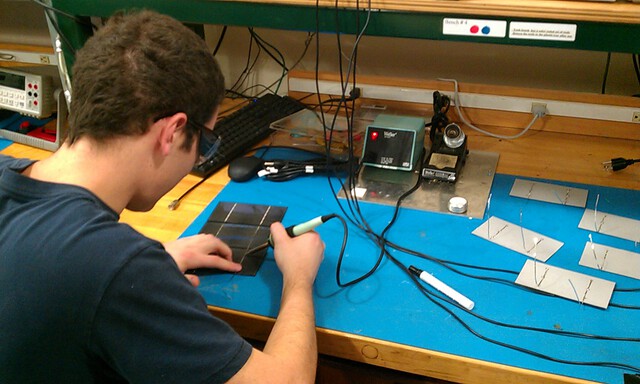
Documentation/SharedImages/2012-02-11 13.01.28.jpg
