farzonl/gtnr/Documentation/SharedImages/2012-02-11 14.27.17.jpg

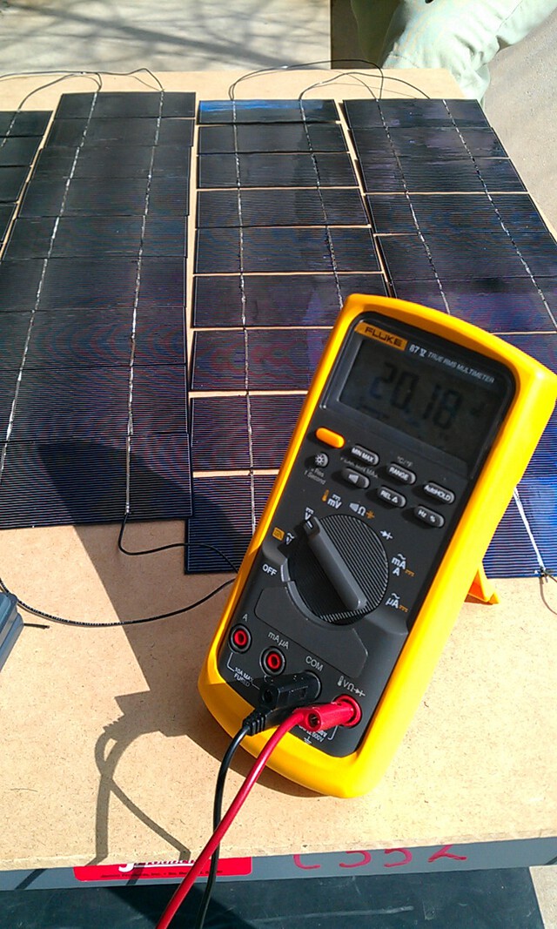
Documentation/SharedImages/2012-02-11 14.27.17.jpg
