farzonl/gtnr/Documentation/SharedImages/2012-02-11 14.27.17_2.jpg

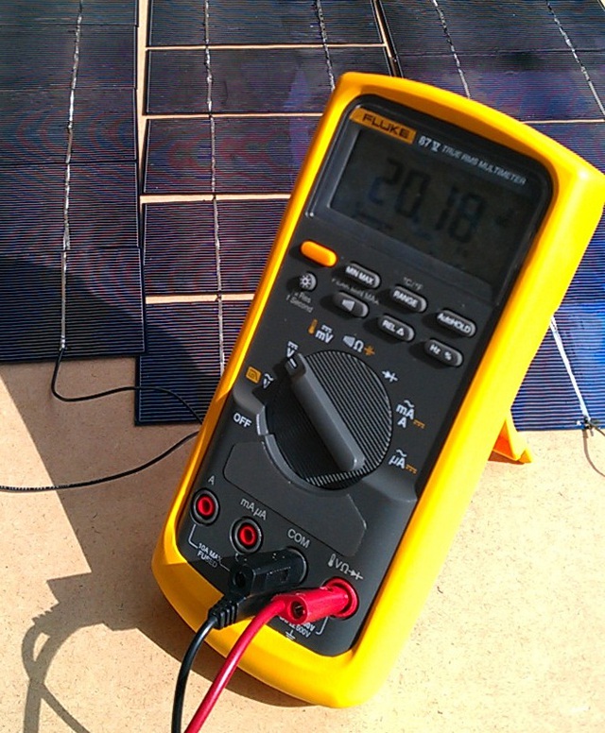
Documentation/SharedImages/2012-02-11 14.27.17_2.jpg
