farzonl/gtnr/Documentation/SharedImages/2012-02-11 15.45.01.jpg

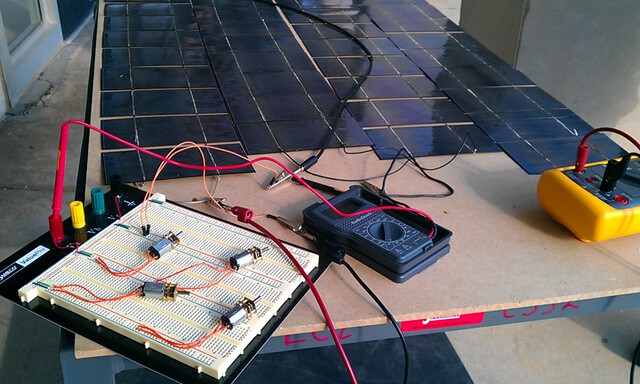
Documentation/SharedImages/2012-02-11 15.45.01.jpg
