farzonl/gtnr/Documentation/SharedImages/2012-02-11 15.45.08.jpg

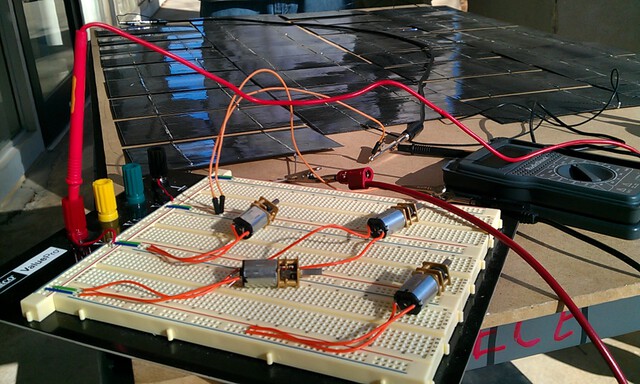
Documentation/SharedImages/2012-02-11 15.45.08.jpg
