farzonl/gtnr/Documentation/SharedImages/2012-02-12 10.33.34.jpg

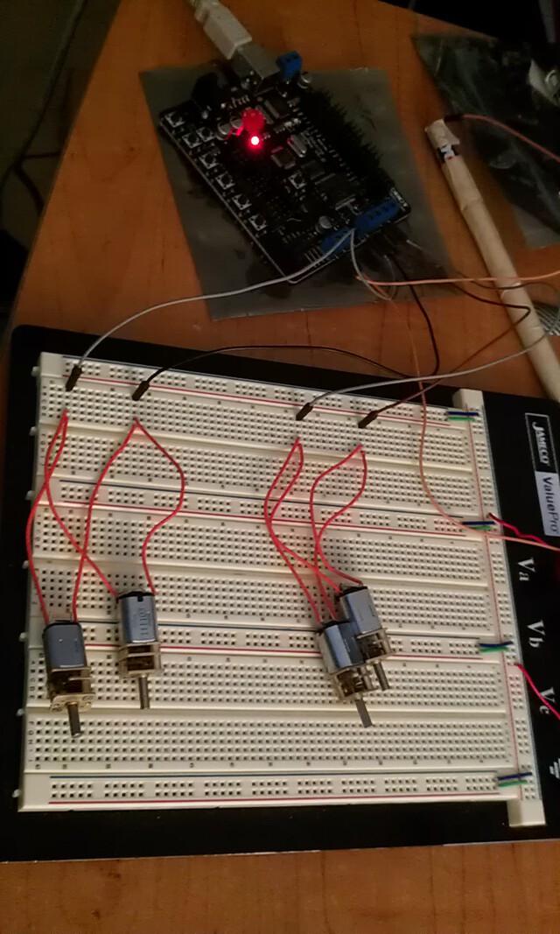
Documentation/SharedImages/2012-02-12 10.33.34.jpg
