farzonl/gtnr/Documentation/SharedImages/2012-02-12 10.33.50.jpg

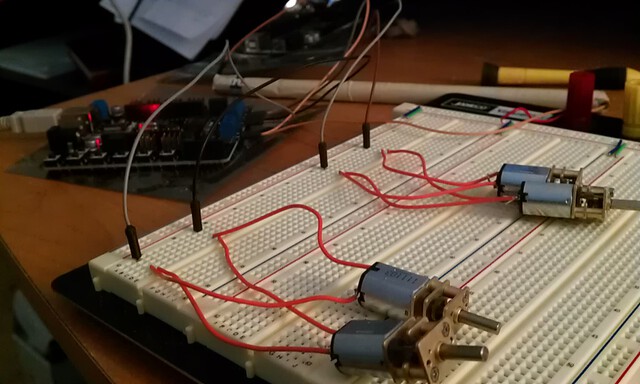
Documentation/SharedImages/2012-02-12 10.33.50.jpg
