farzonl/gtnr/Documentation/SharedImages/2012-02-18 13.44.46.jpg

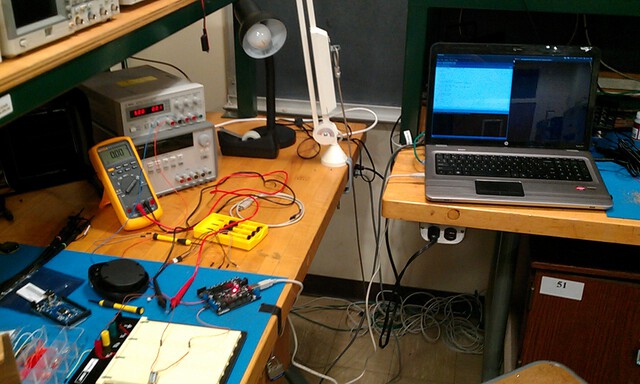
Documentation/SharedImages/2012-02-18 13.44.46.jpg
