farzonl/gtnr/Documentation/SharedImages/2012-02-18 13.44.53.jpg

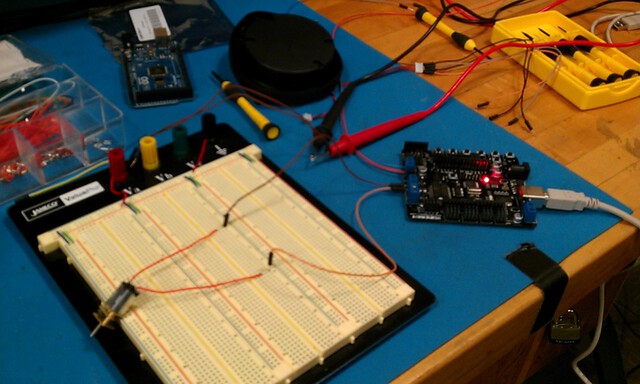
Documentation/SharedImages/2012-02-18 13.44.53.jpg
