farzonl/gtnr/Documentation/SharedImages/2012-02-18 23.26.38.jpg

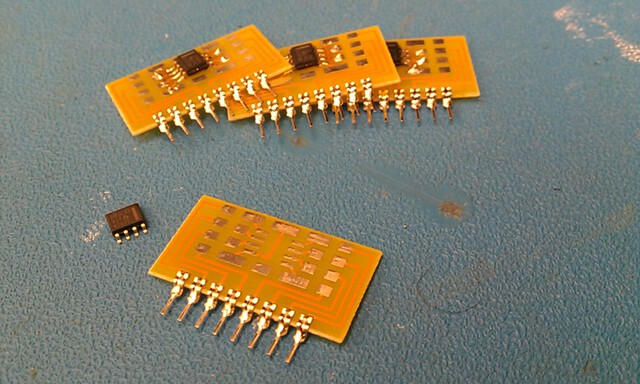
Documentation/SharedImages/2012-02-18 23.26.38.jpg
