farzonl/gtnr/Documentation/SharedImages/2012-02-26 13.32.24.jpg

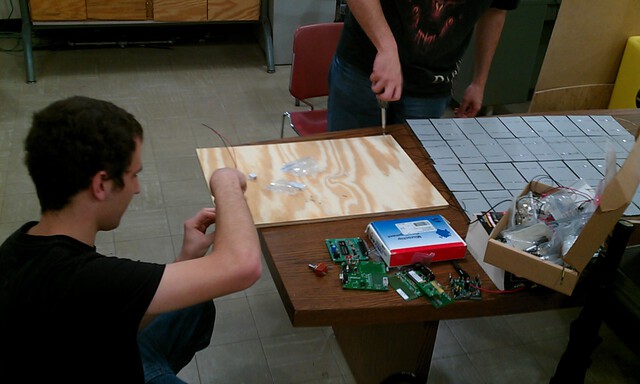
Documentation/SharedImages/2012-02-26 13.32.24.jpg
