farzonl/gtnr/Documentation/SharedImages/2012-02-26 13.32.34.jpg

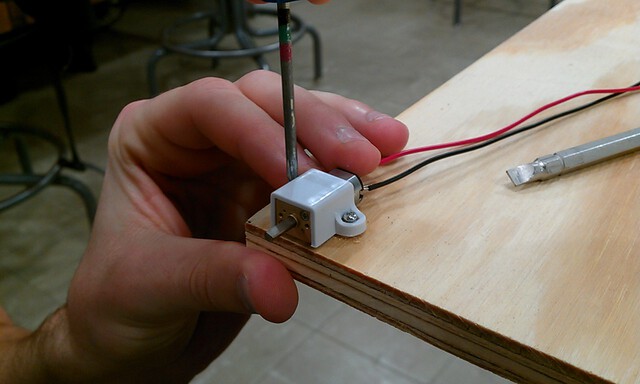
Documentation/SharedImages/2012-02-26 13.32.34.jpg
