farzonl/gtnr/Documentation/SharedImages/2012-02-26 15.22.45.jpg

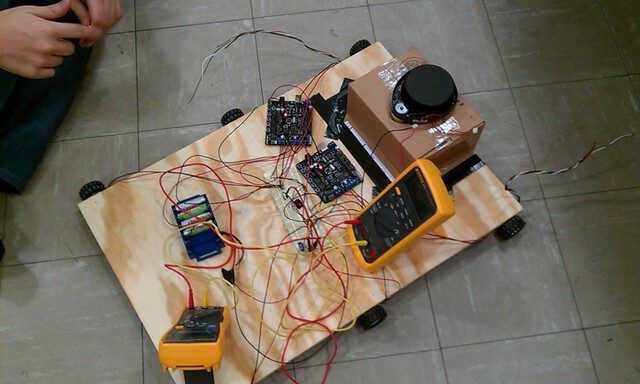
Documentation/SharedImages/2012-02-26 15.22.45.jpg
