farzonl/gtnr/Documentation/SharedImages/2012-02-26 15.40.47.jpg

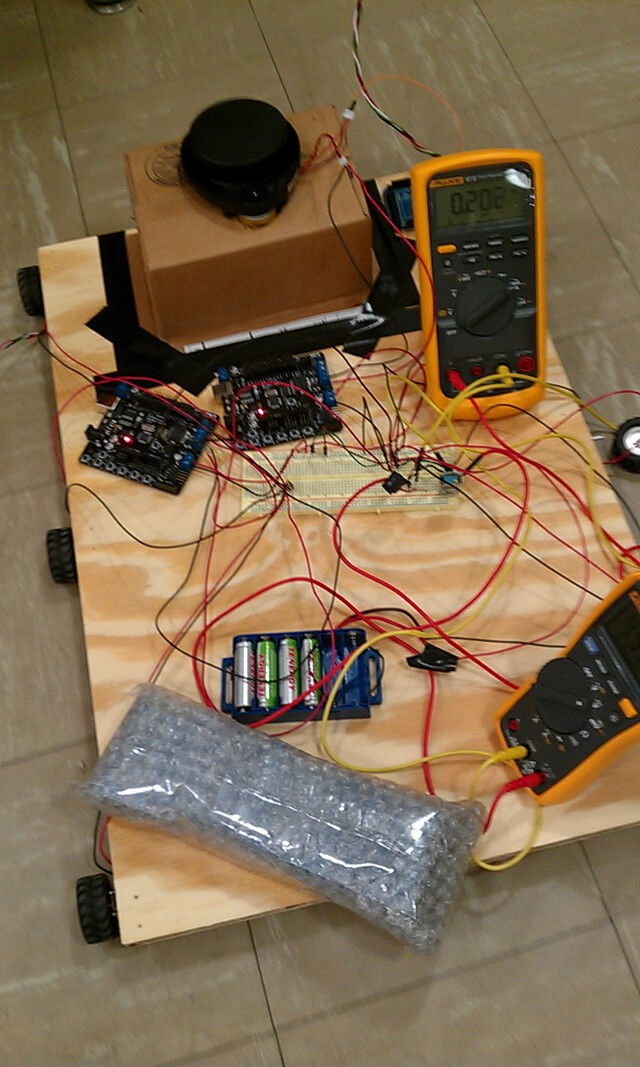
Documentation/SharedImages/2012-02-26 15.40.47.jpg
