farzonl/gtnr/Documentation/SharedImages/2012-03-23 05.36.51.jpg

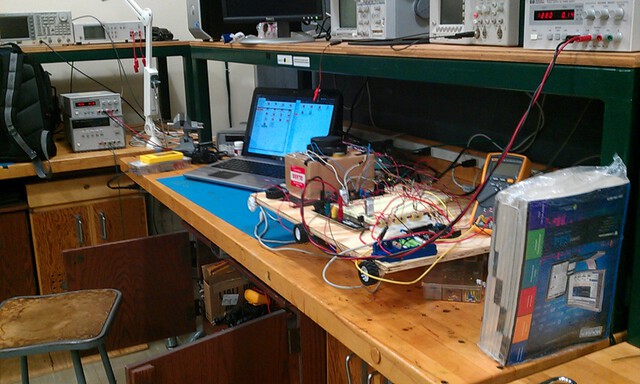
Documentation/SharedImages/2012-03-23 05.36.51.jpg
