farzonl/gtnr/Documentation/SharedImages/2012-03-23 05.37.02.jpg

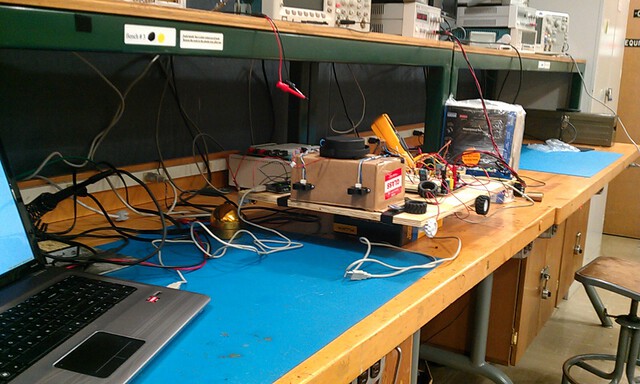
Documentation/SharedImages/2012-03-23 05.37.02.jpg
