farzonl/gtnr/Documentation/SharedImages/2012-03-30 10.30.28.jpg

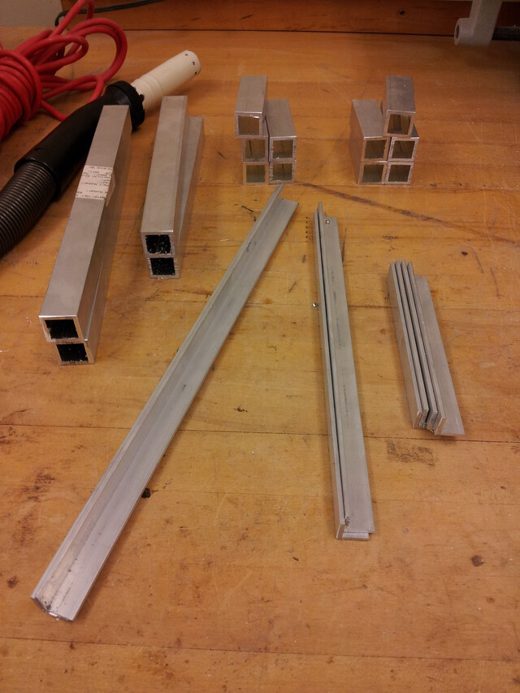
Documentation/SharedImages/2012-03-30 10.30.28.jpg
