farzonl/gtnr/Documentation/SharedImages/2012-03-30 10.30.34.jpg

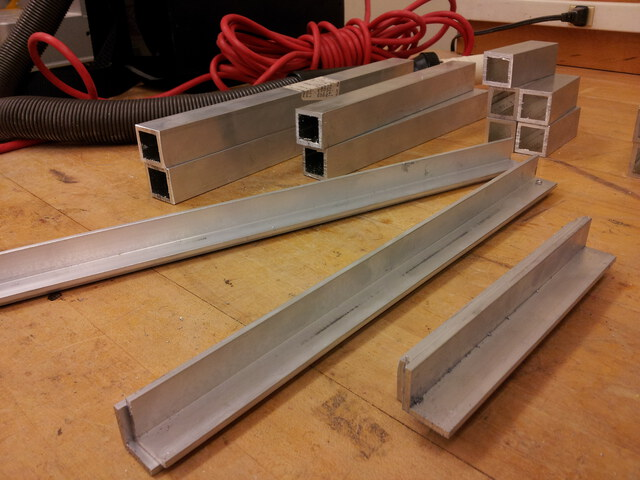
Documentation/SharedImages/2012-03-30 10.30.34.jpg
