farzonl/gtnr/Documentation/SharedImages/2012-03-30 10.34.21.jpg

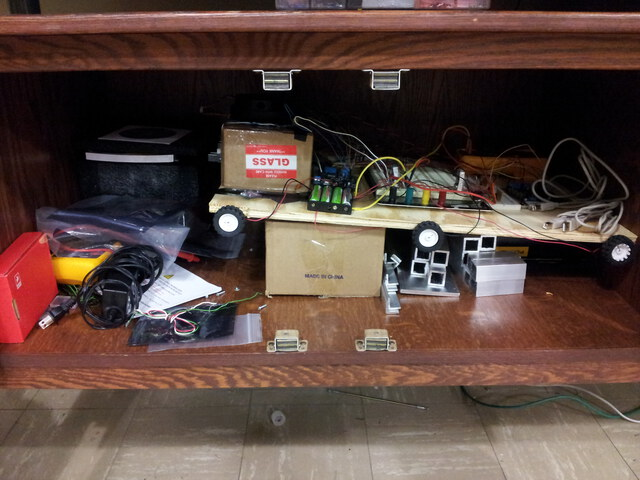
Documentation/SharedImages/2012-03-30 10.34.21.jpg
