farzonl/gtnr/Documentation/SharedImages/2012-04-08 04.37.58.jpg

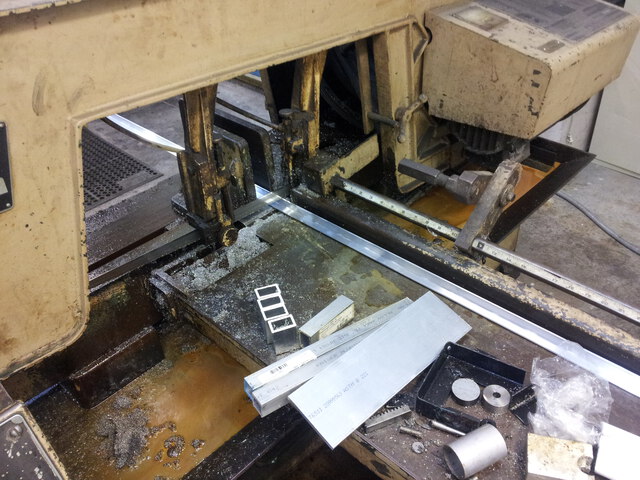
Documentation/SharedImages/2012-04-08 04.37.58.jpg
