farzonl/gtnr/Documentation/SharedImages/2012-04-08 04.54.39.jpg

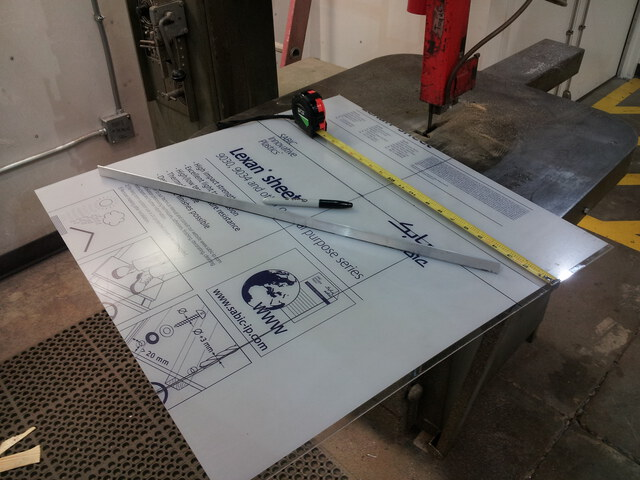
Documentation/SharedImages/2012-04-08 04.54.39.jpg
