farzonl/gtnr/Documentation/SharedImages/2012-04-08 07.07.34.jpg

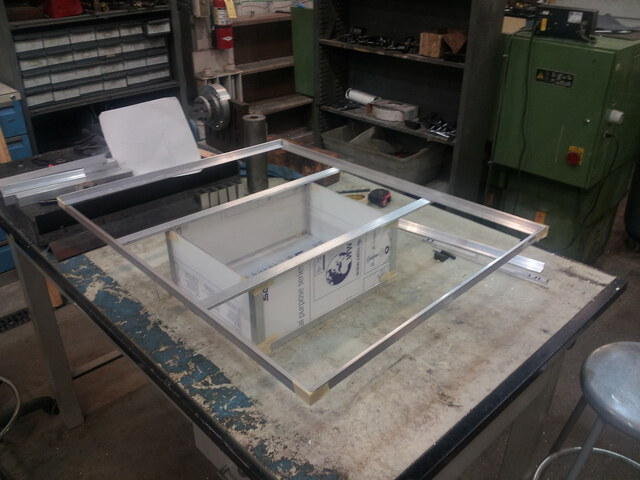
Documentation/SharedImages/2012-04-08 07.07.34.jpg
