farzonl/gtnr/Documentation/SharedImages/2012-04-08 07.07.41.jpg

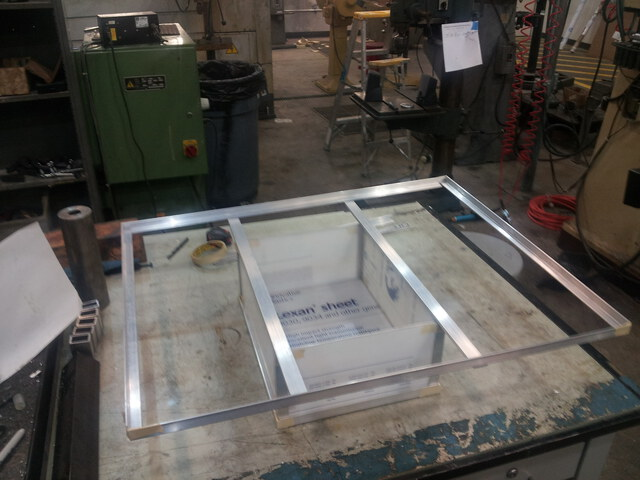
Documentation/SharedImages/2012-04-08 07.07.41.jpg
