farzonl/gtnr/Documentation/SharedImages/2012-04-08 07.16.18.jpg

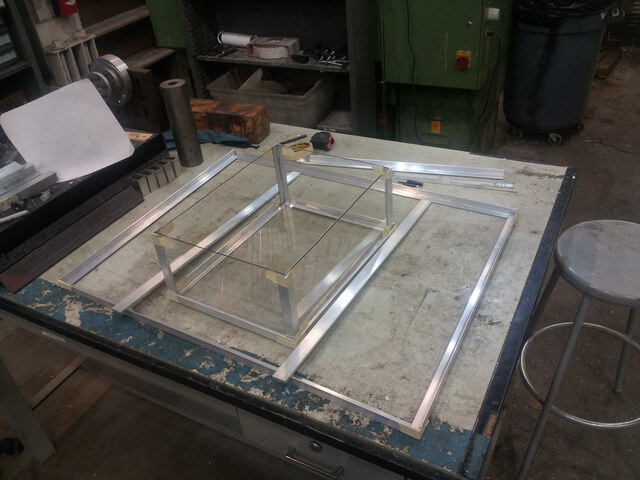
Documentation/SharedImages/2012-04-08 07.16.18.jpg
