farzonl/gtnr/Documentation/SharedImages/2012-04-08 07.17.06.jpg

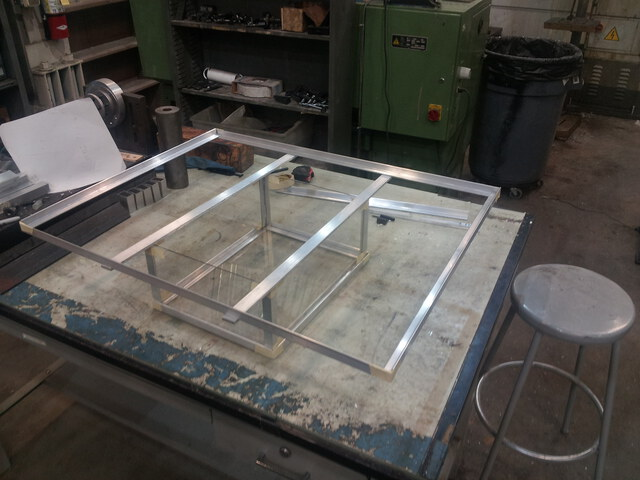
Documentation/SharedImages/2012-04-08 07.17.06.jpg
