farzonl/gtnr/Documentation/SharedImages/2012-04-08 07.26.31.jpg

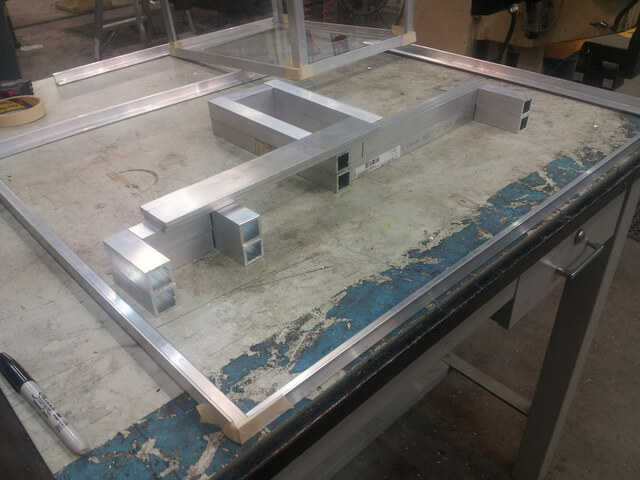
Documentation/SharedImages/2012-04-08 07.26.31.jpg
