farzonl/gtnr/Documentation/SharedImages/2012-04-08 07.55.00.jpg

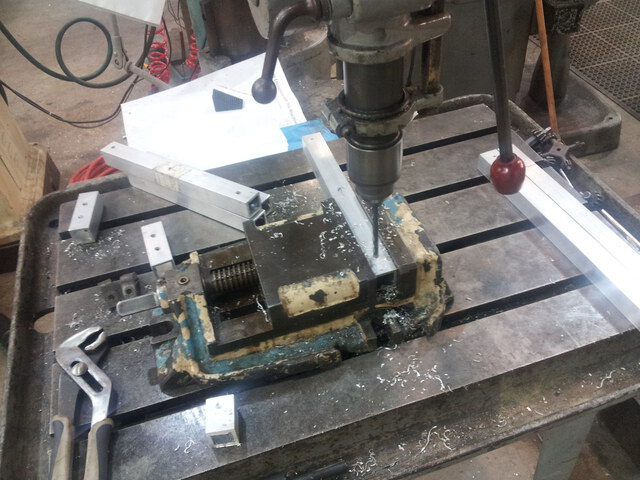
Documentation/SharedImages/2012-04-08 07.55.00.jpg
