farzonl/gtnr/Documentation/SharedImages/2012-04-08 08.10.27.jpg

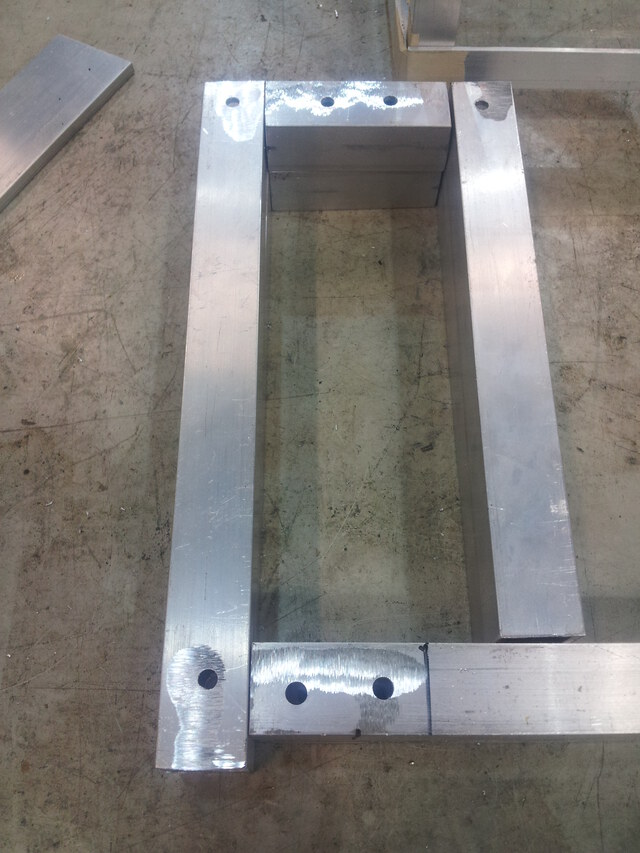
Documentation/SharedImages/2012-04-08 08.10.27.jpg
