farzonl/gtnr/Documentation/SharedImages/2012-04-08 08.10.37_2.jpg

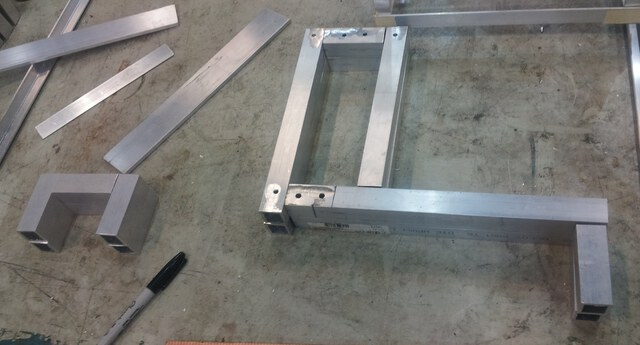
Documentation/SharedImages/2012-04-08 08.10.37_2.jpg
