farzonl/gtnr/Documentation/SharedImages/2012-04-08 08.15.33.jpg

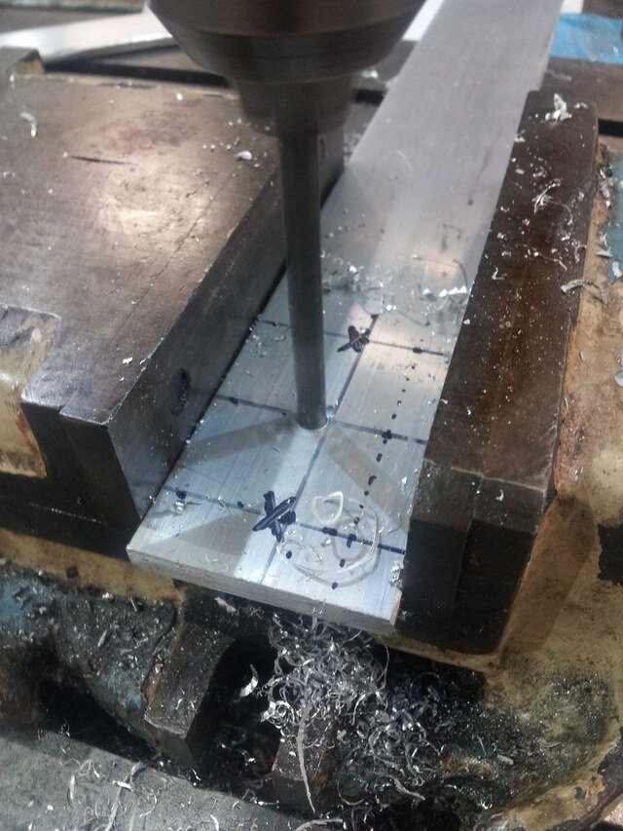
Documentation/SharedImages/2012-04-08 08.15.33.jpg
