farzonl/gtnr/Documentation/SharedImages/2012-04-08 08.35.59.jpg

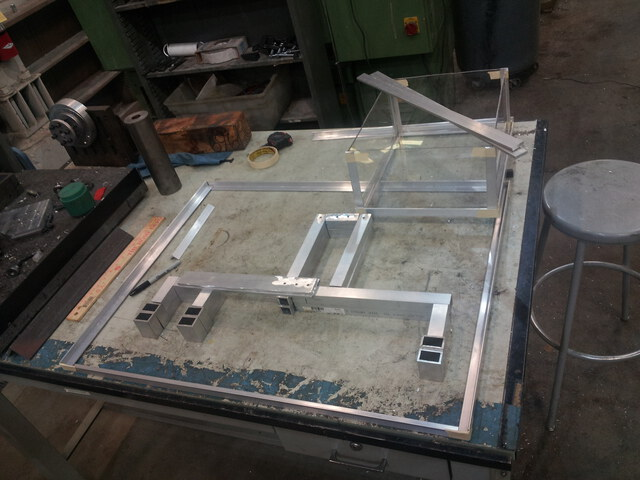
Documentation/SharedImages/2012-04-08 08.35.59.jpg
