farzonl/gtnr/Documentation/SharedImages/2012-04-08 11.19.07.jpg

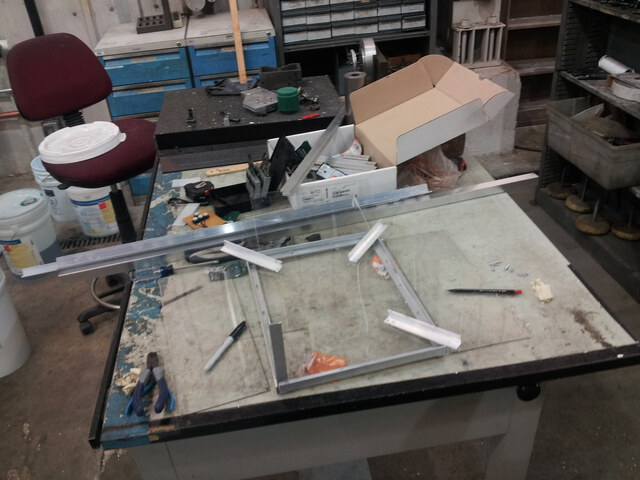
Documentation/SharedImages/2012-04-08 11.19.07.jpg
