farzonl/gtnr/Documentation/SharedImages/2012-04-08 12.44.28.jpg

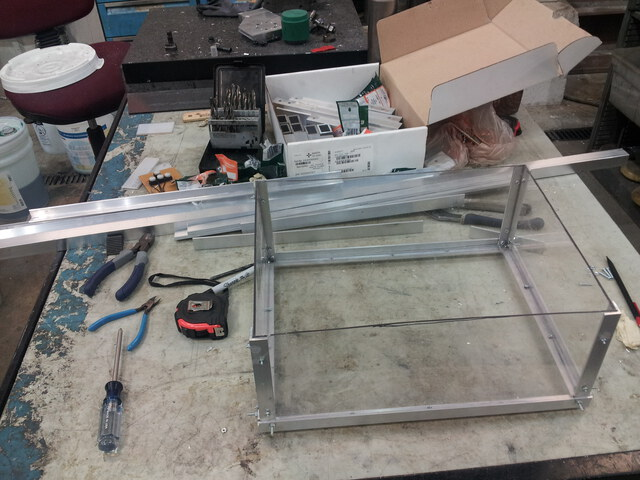
Documentation/SharedImages/2012-04-08 12.44.28.jpg
