farzonl/gtnr/Documentation/SharedImages/2012-04-08 17.21.14.jpg

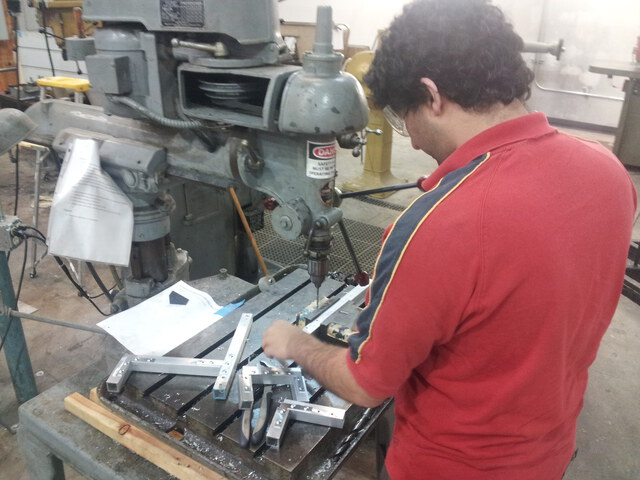
Documentation/SharedImages/2012-04-08 17.21.14.jpg
