farzonl/gtnr/Documentation/SharedImages/2012-04-08 17.21.18.jpg

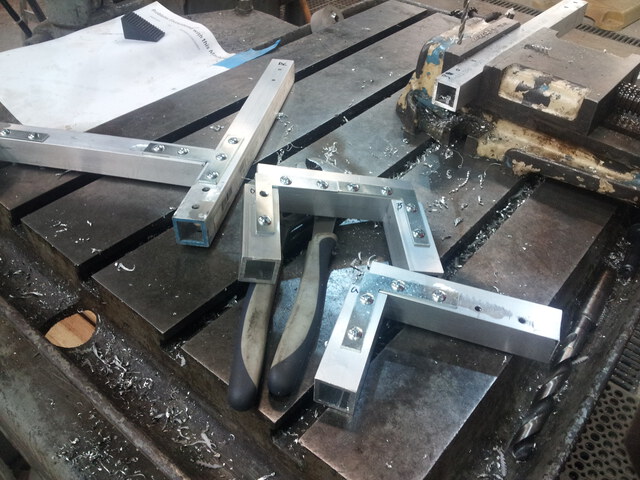
Documentation/SharedImages/2012-04-08 17.21.18.jpg
