farzonl/gtnr/Documentation/SharedImages/2012-04-08 17.54.35.jpg

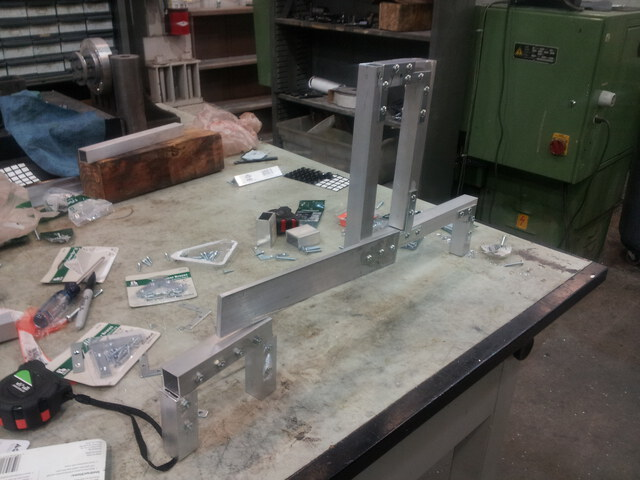
Documentation/SharedImages/2012-04-08 17.54.35.jpg
