farzonl/gtnr/Documentation/SharedImages/2012-04-08 17.54.47.jpg

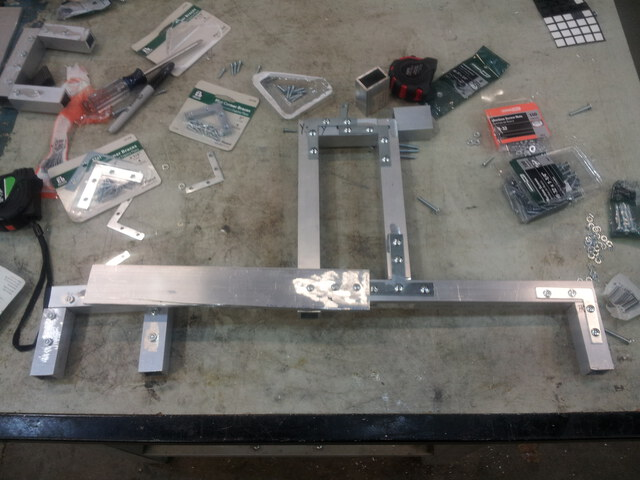
Documentation/SharedImages/2012-04-08 17.54.47.jpg
