farzonl/gtnr/Documentation/SharedImages/2012-04-08 18.00.47.jpg

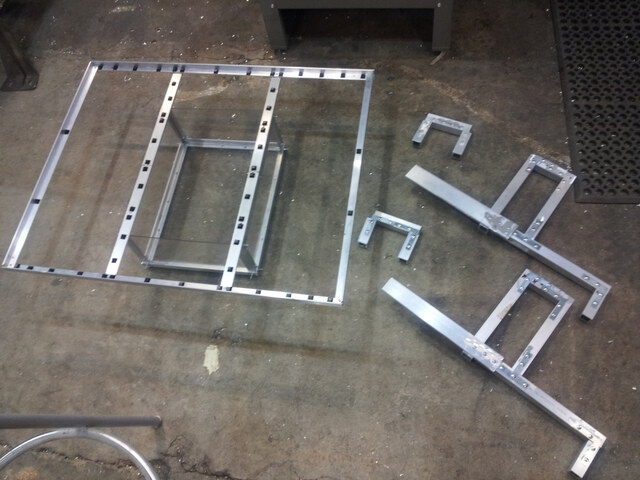
Documentation/SharedImages/2012-04-08 18.00.47.jpg
