farzonl/gtnr/Documentation/SharedImages/2012-04-08 18.00.52.jpg

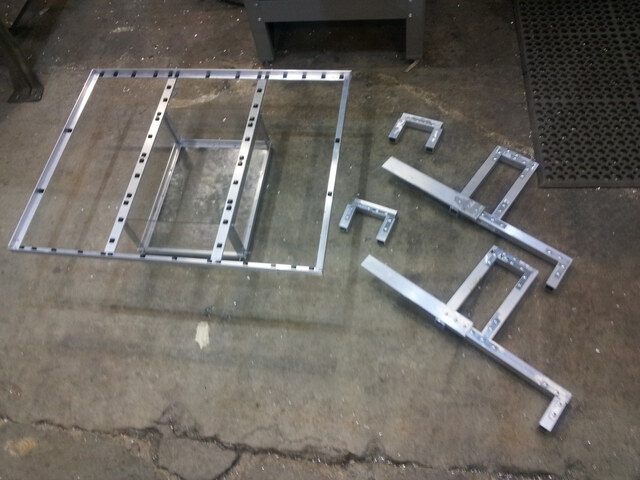
Documentation/SharedImages/2012-04-08 18.00.52.jpg
