farzonl/gtnr/Documentation/SharedImages/2012-04-08 18.01.03.jpg

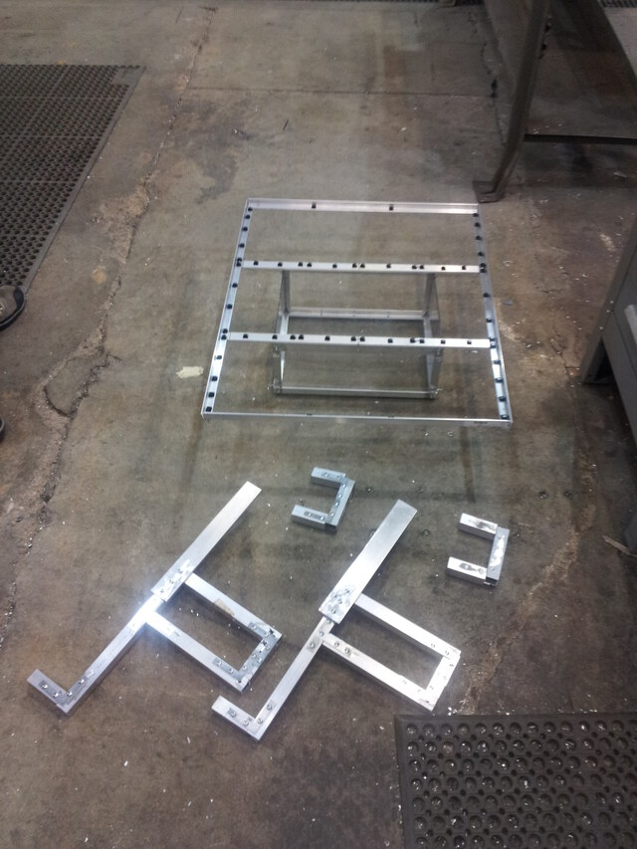
Documentation/SharedImages/2012-04-08 18.01.03.jpg
