farzonl/gtnr/Documentation/SharedImages/2012-04-09 22.45.47.jpg

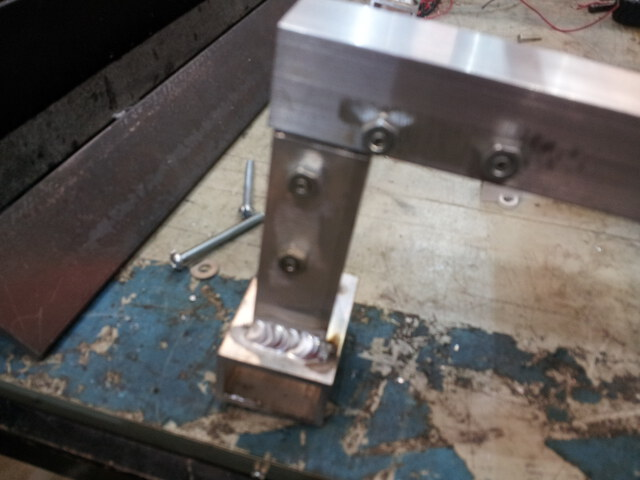
Documentation/SharedImages/2012-04-09 22.45.47.jpg
