farzonl/gtnr/Documentation/SharedImages/2012-04-09 22.46.35.jpg

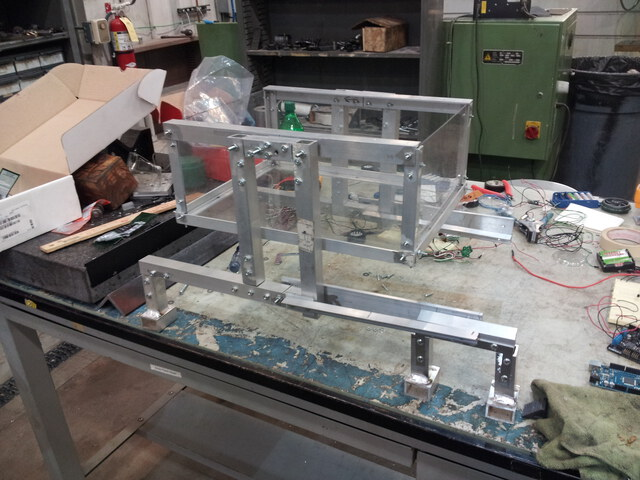
Documentation/SharedImages/2012-04-09 22.46.35.jpg
