farzonl/gtnr/Documentation/SharedImages/2012-04-09 23.41.43.jpg

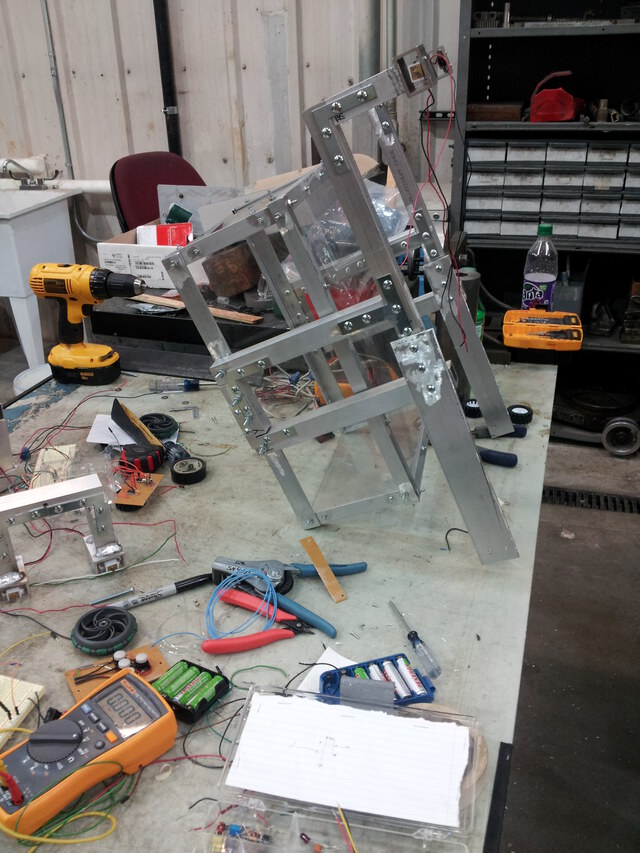
Documentation/SharedImages/2012-04-09 23.41.43.jpg
