farzonl/gtnr/Documentation/SharedImages/2012-04-09 23.59.08.jpg

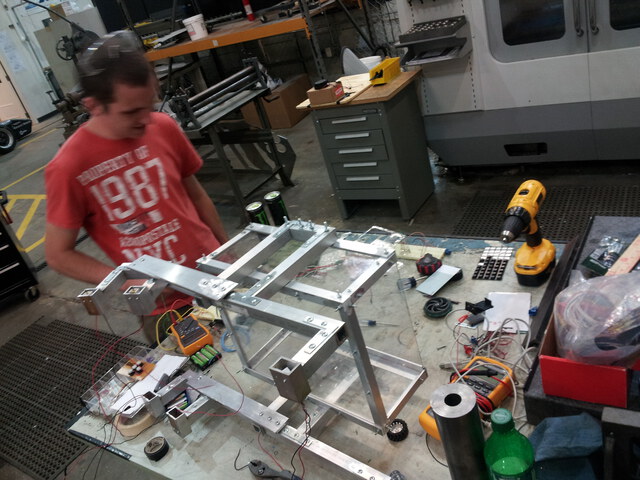
Documentation/SharedImages/2012-04-09 23.59.08.jpg
