farzonl/gtnr/Documentation/SharedImages/2012-04-10 00.33.05.jpg

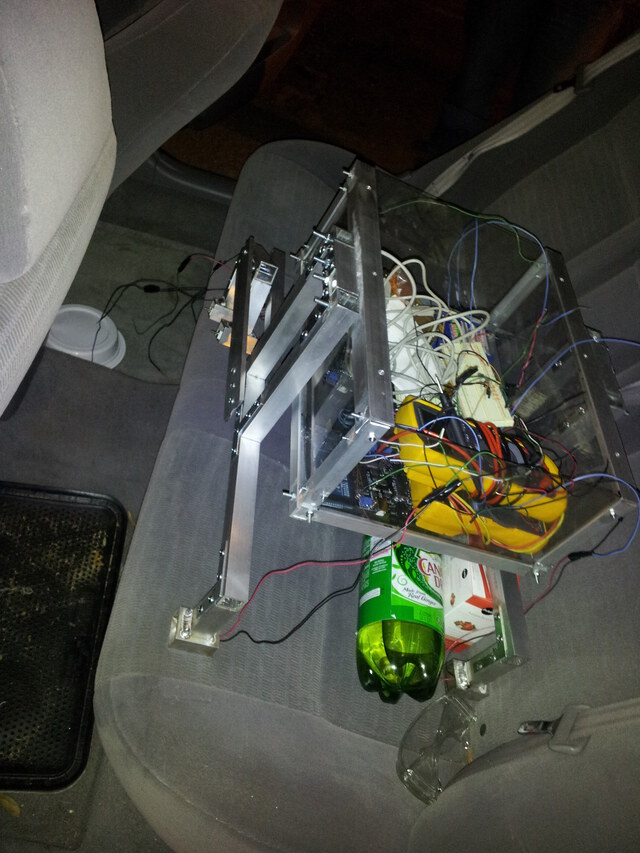
Documentation/SharedImages/2012-04-10 00.33.05.jpg
