farzonl/gtnr/Documentation/SharedImages/2012-04-10 00.59.18.jpg

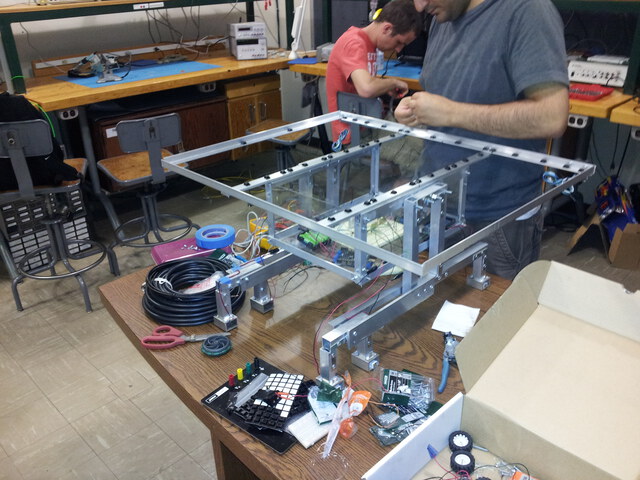
Documentation/SharedImages/2012-04-10 00.59.18.jpg
