farzonl/gtnr/Documentation/SharedImages/2012-04-17 01.05.19.jpg

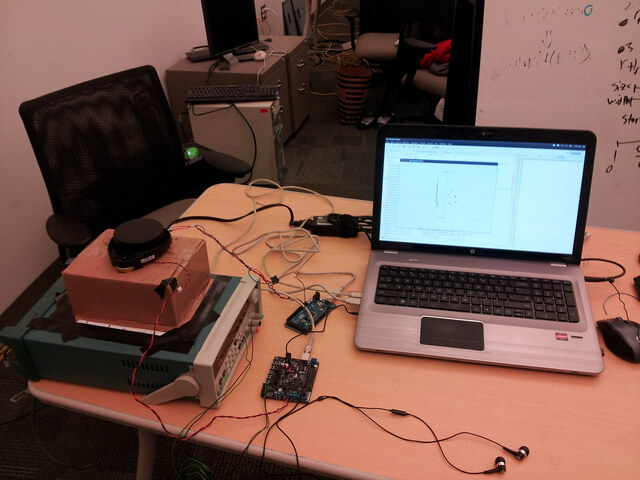
Documentation/SharedImages/2012-04-17 01.05.19.jpg
