farzonl/gtnr/Documentation/SharedImages/2012-04-17 01.05.37.jpg

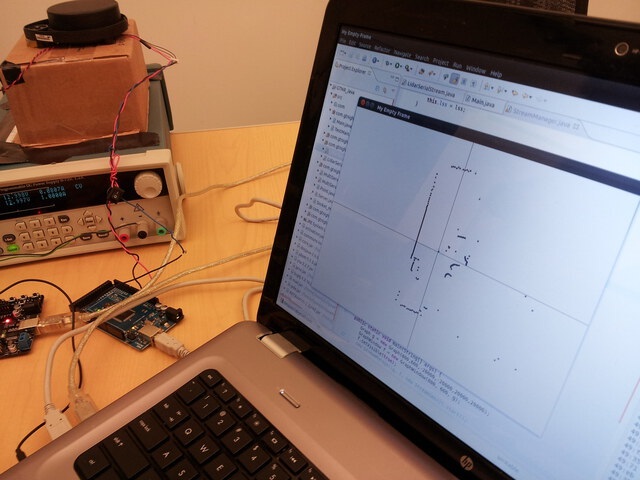
Documentation/SharedImages/2012-04-17 01.05.37.jpg
