farzonl/gtnr/Documentation/SharedImages/2012-04-19 20.15.26_2_small.jpg

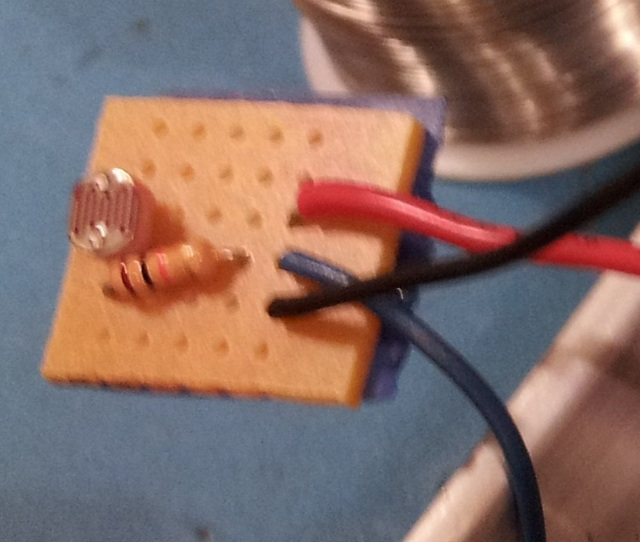
Documentation/SharedImages/2012-04-19 20.15.26_2_small.jpg
