farzonl/gtnr/Documentation/SharedImages/2012-04-19 20.15.54.jpg

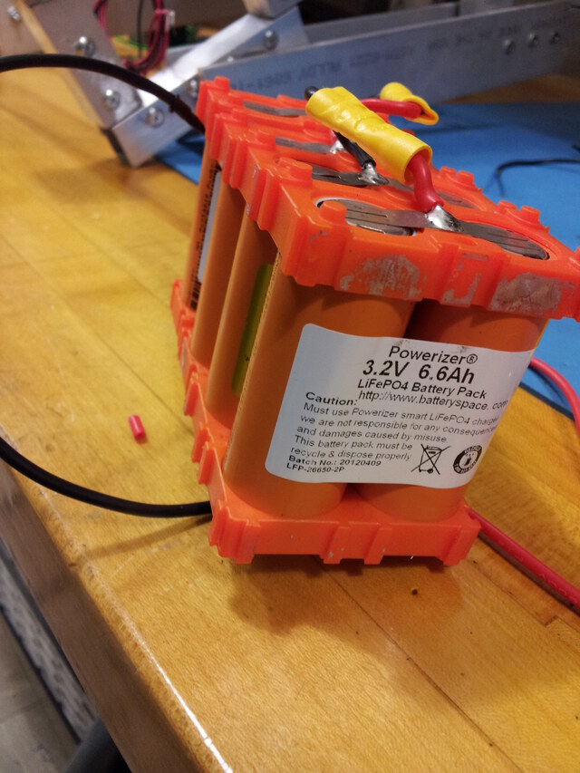
Documentation/SharedImages/2012-04-19 20.15.54.jpg
