farzonl/gtnr/Documentation/SharedImages/2012-04-20 22.57.25.jpg

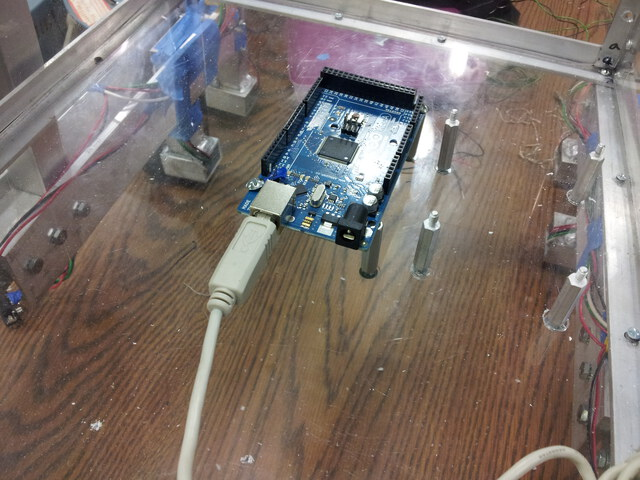
Documentation/SharedImages/2012-04-20 22.57.25.jpg
