farzonl/gtnr/Documentation/SharedImages/2012-04-20 23.16.06.jpg

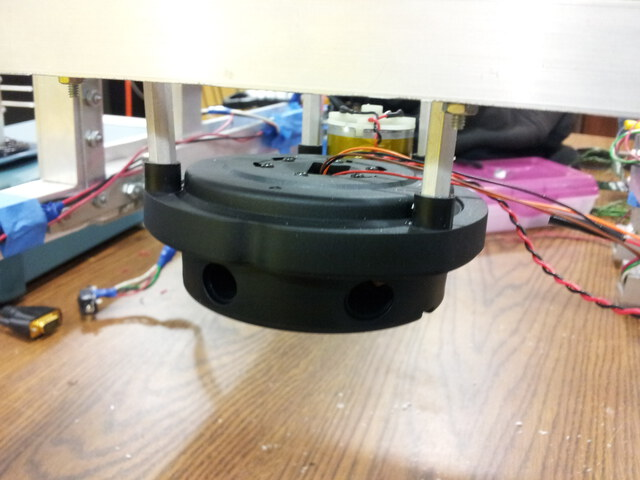
Documentation/SharedImages/2012-04-20 23.16.06.jpg
