farzonl/gtnr/Documentation/SharedImages/2012-04-20 23.36.39.jpg

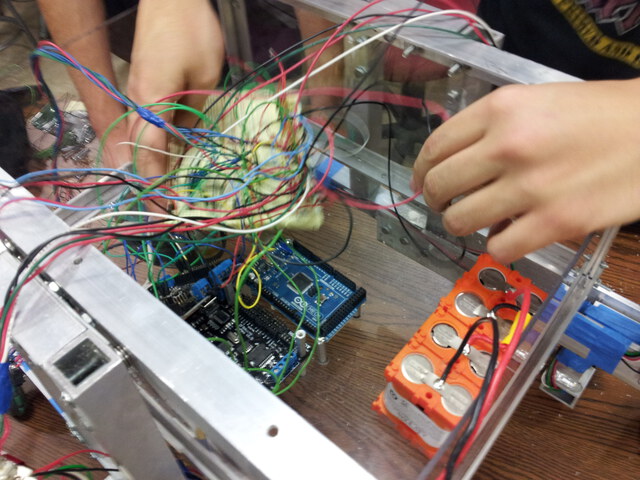
Documentation/SharedImages/2012-04-20 23.36.39.jpg
