farzonl/gtnr/Documentation/SharedImages/2012-04-21 00.52.07.jpg

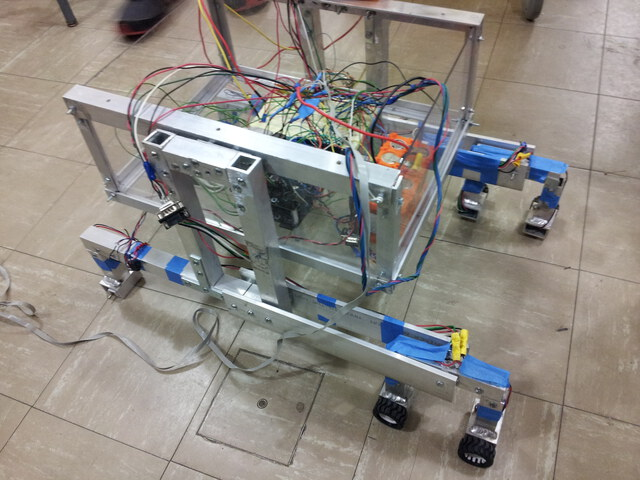
Documentation/SharedImages/2012-04-21 00.52.07.jpg
