farzonl/gtnr/Documentation/SharedImages/2012-04-23 16.24.44.jpg

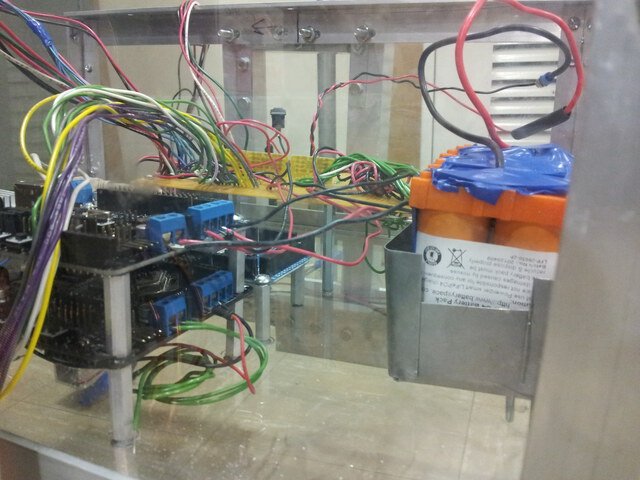
Documentation/SharedImages/2012-04-23 16.24.44.jpg
