farzonl/gtnr/Documentation/SharedImages/2012-04-23 16.25.37.jpg

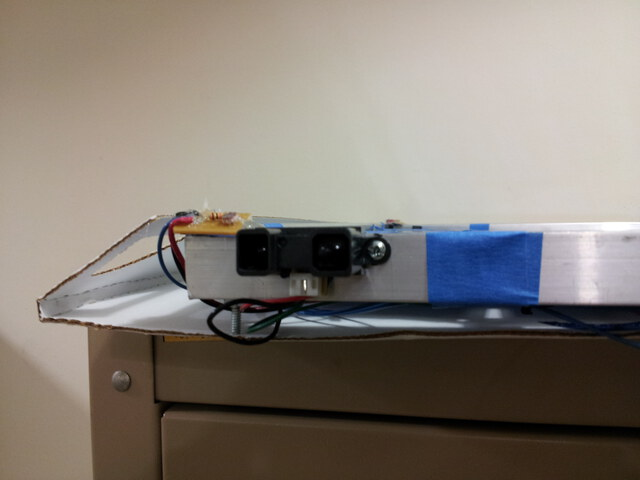
Documentation/SharedImages/2012-04-23 16.25.37.jpg
