farzonl/gtnr/Documentation/SharedImages/2012-04-23 16.26.56.jpg

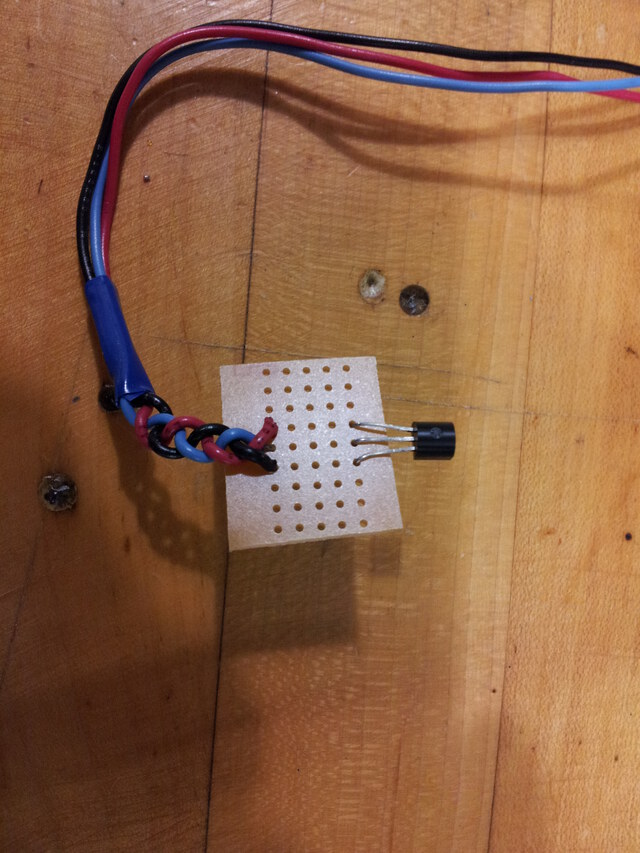
Documentation/SharedImages/2012-04-23 16.26.56.jpg
