farzonl/gtnr/Documentation/SharedImages/AtomBoard.jpg

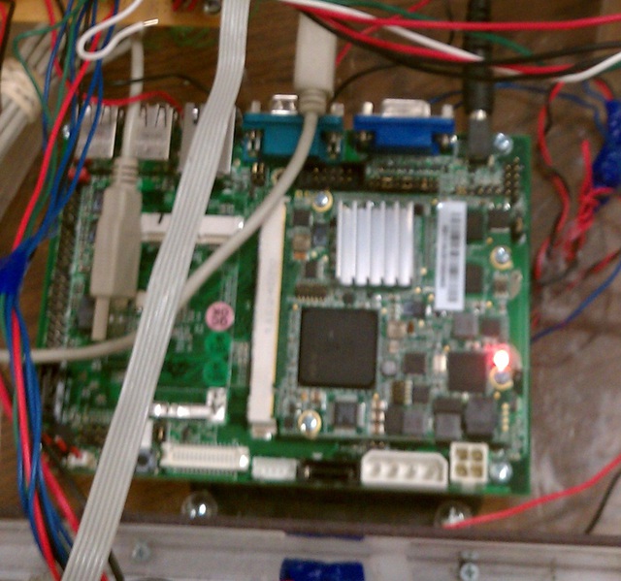
Documentation/SharedImages/AtomBoard.jpg
