farzonl/gtnr/Documentation/SharedImages/IMAG1581.jpg

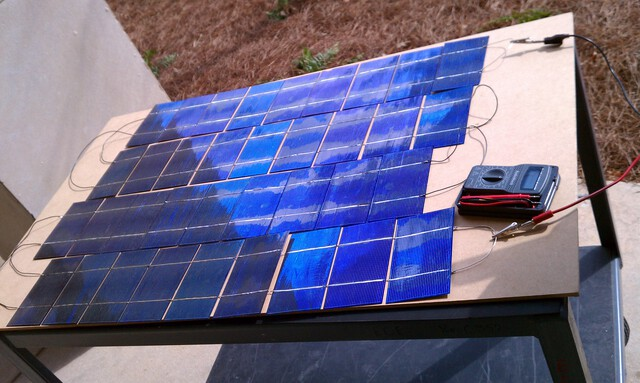
Documentation/SharedImages/IMAG1581.jpg
