farzonl/gtnr/Documentation/SharedImages/IMAG1582.jpg

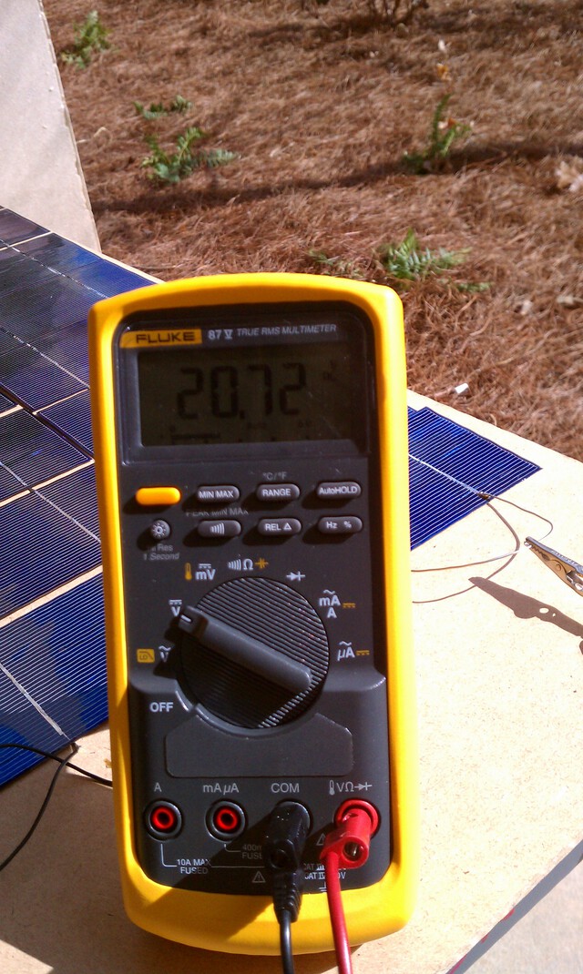
Documentation/SharedImages/IMAG1582.jpg
