farzonl/gtnr/Documentation/SharedImages/IMAG1583.jpg

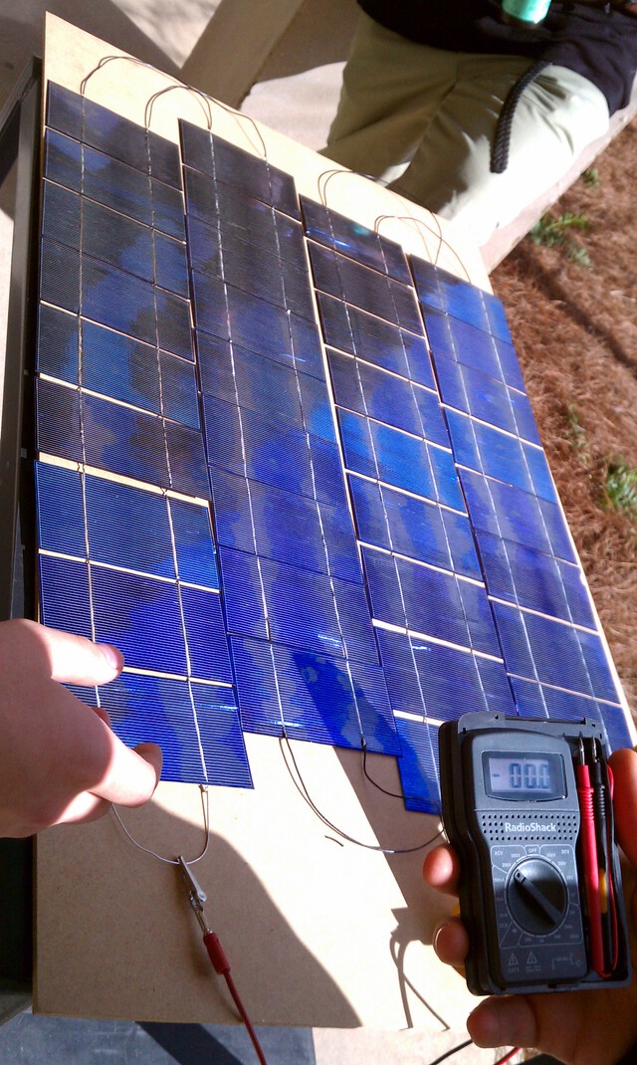
Documentation/SharedImages/IMAG1583.jpg
