farzonl/gtnr/Documentation/SharedImages/IMAG1587.jpg

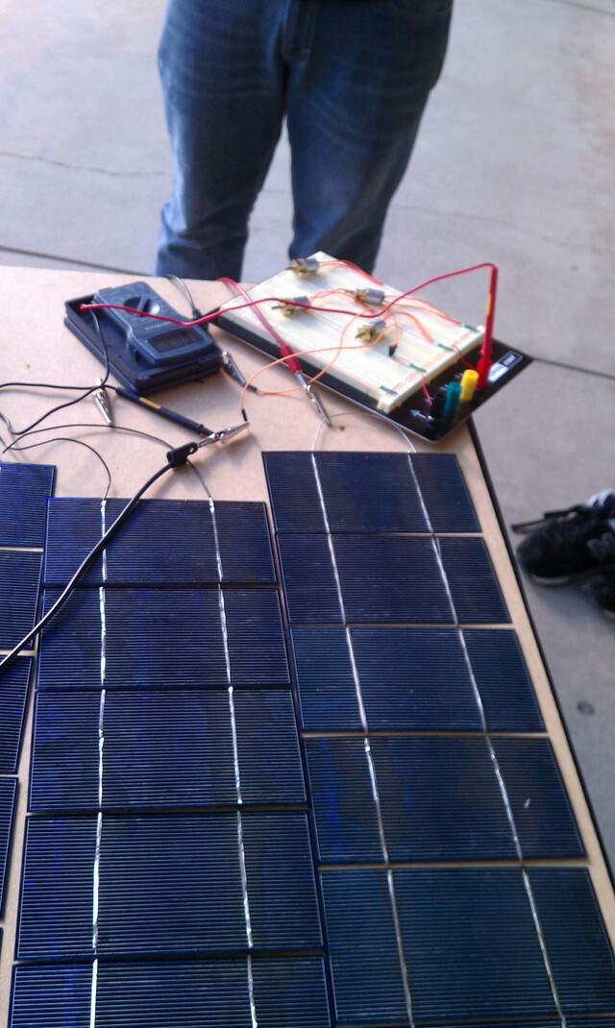
Documentation/SharedImages/IMAG1587.jpg
