farzonl/gtnr/Documentation/SharedImages/IMAG1588.jpg

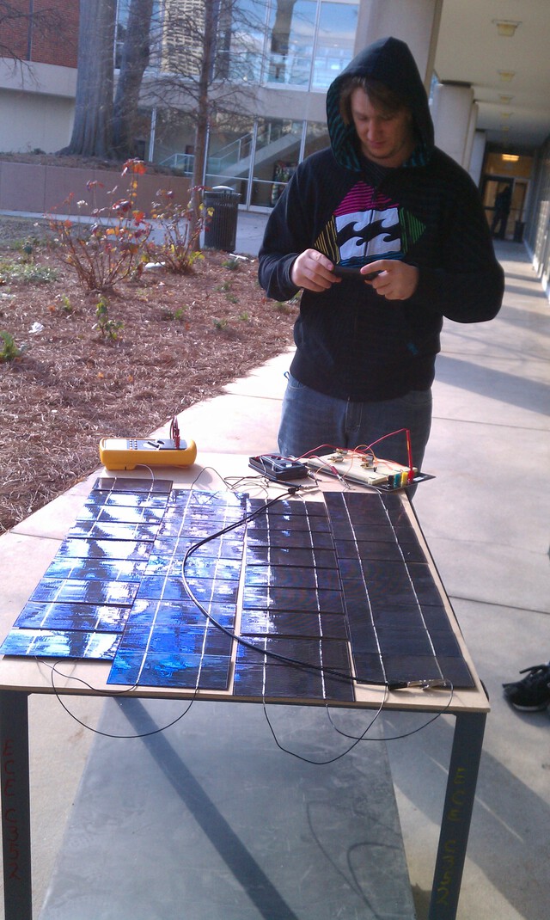
Documentation/SharedImages/IMAG1588.jpg
