farzonl/gtnr/Documentation/SharedImages/IMAG1589.jpg

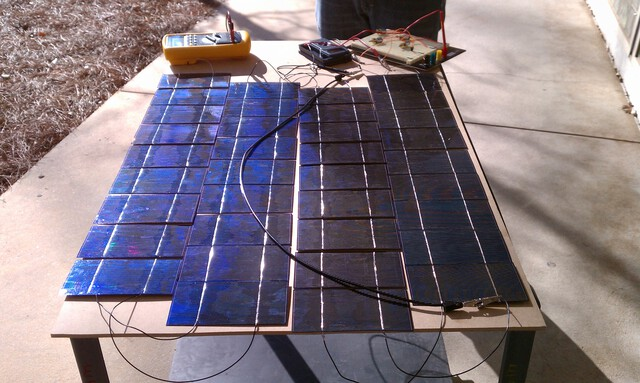
Documentation/SharedImages/IMAG1589.jpg
