farzonl/gtnr/Documentation/SharedImages/IMAG1606.jpg

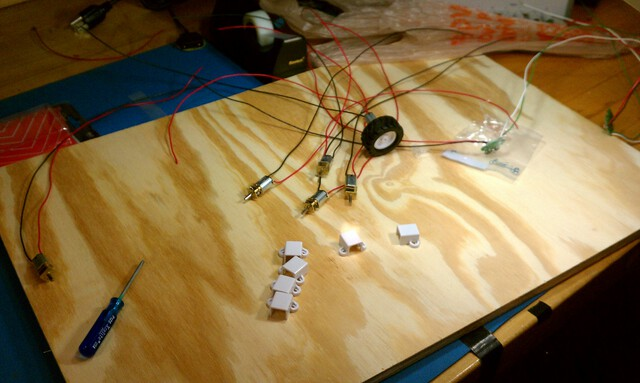
Documentation/SharedImages/IMAG1606.jpg
