farzonl/gtnr/Documentation/SharedImages/IMAG1607.jpg

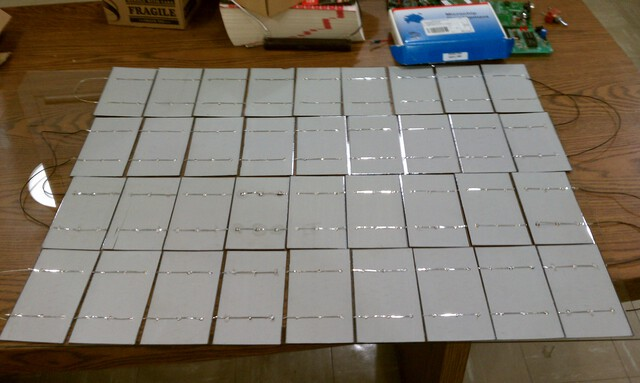
Documentation/SharedImages/IMAG1607.jpg
