farzonl/gtnr/Documentation/SharedImages/IMAG1608.jpg

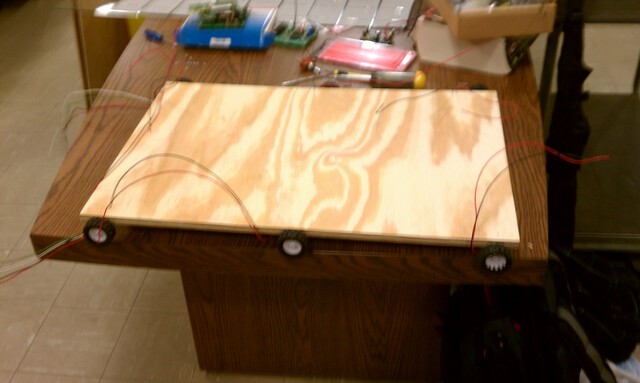
Documentation/SharedImages/IMAG1608.jpg
