farzonl/gtnr/Documentation/SharedImages/IMAG1609.jpg

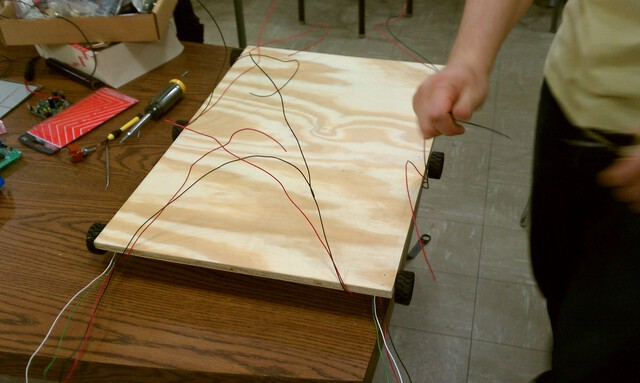
Documentation/SharedImages/IMAG1609.jpg
