farzonl/gtnr/Documentation/SharedImages/IMAG1610.jpg

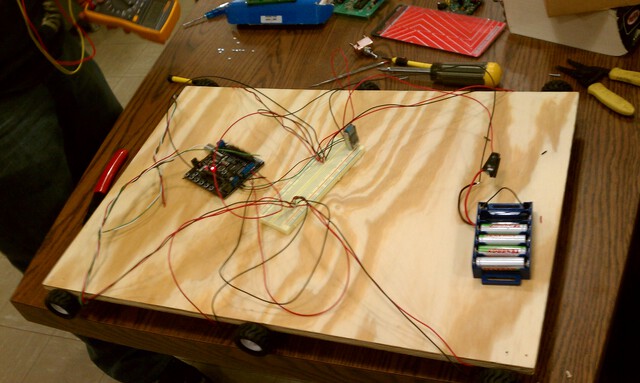
Documentation/SharedImages/IMAG1610.jpg
