farzonl/gtnr/Documentation/SharedImages/IMAG1611.jpg

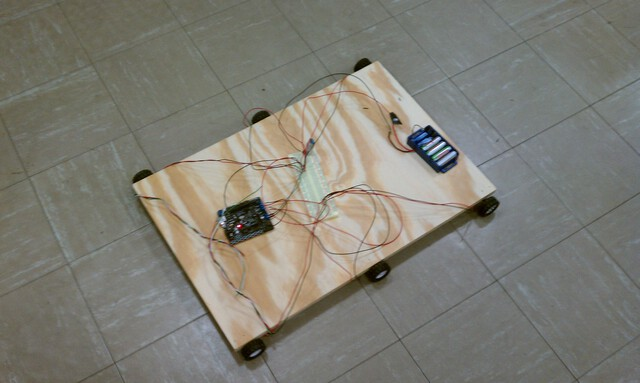
Documentation/SharedImages/IMAG1611.jpg
