farzonl/gtnr/Documentation/SharedImages/IMAG1612.jpg

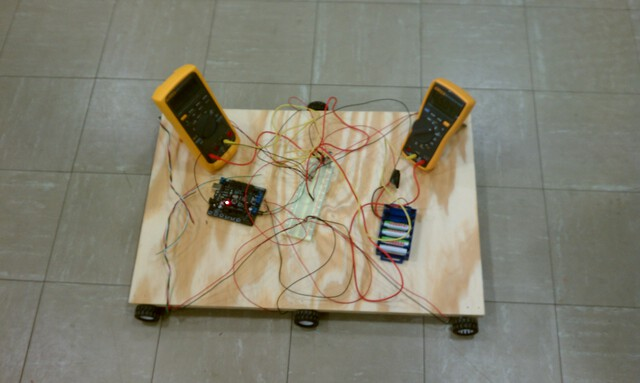
Documentation/SharedImages/IMAG1612.jpg
