farzonl/gtnr/Documentation/SharedImages/IMAG1613.jpg

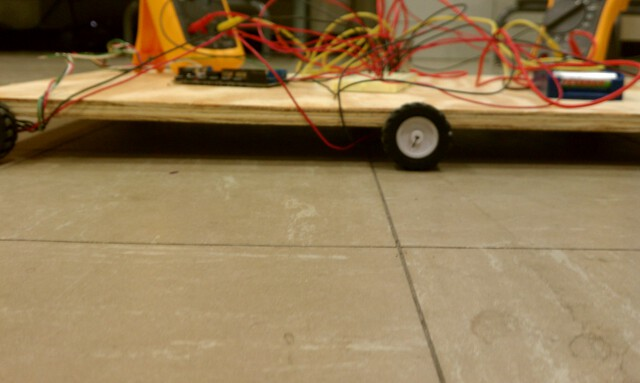
Documentation/SharedImages/IMAG1613.jpg
