farzonl/gtnr/Documentation/SharedImages/IMAG1614.jpg

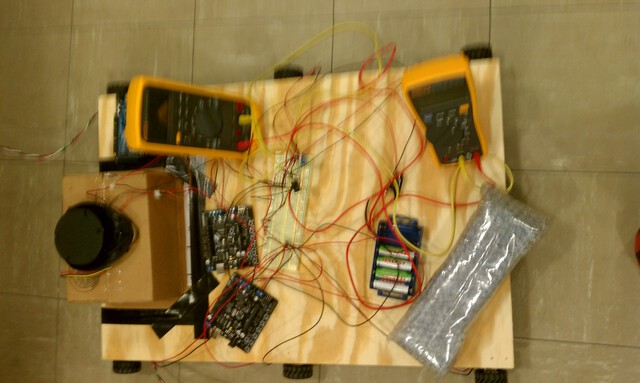
Documentation/SharedImages/IMAG1614.jpg
