farzonl/gtnr/Documentation/SharedImages/IMAG1615.jpg

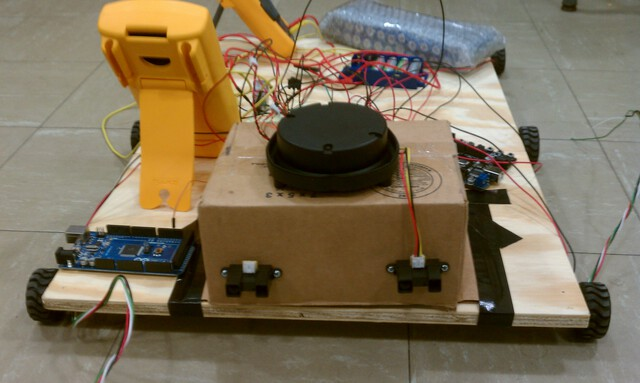
Documentation/SharedImages/IMAG1615.jpg
