farzonl/gtnr/Documentation/SharedImages/IMAG1616.jpg

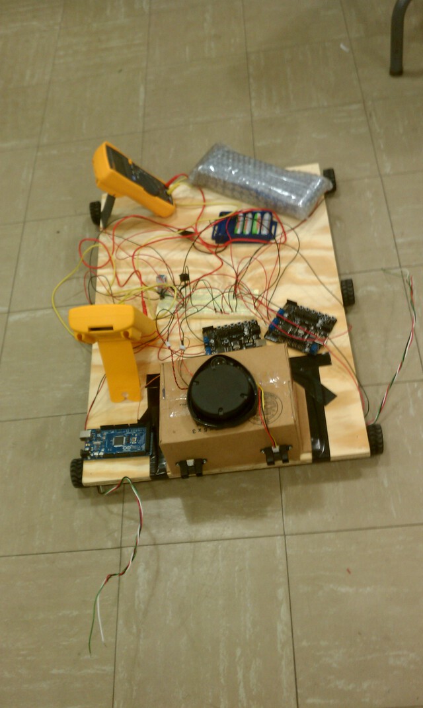
Documentation/SharedImages/IMAG1616.jpg
