farzonl/gtnr/Documentation/SharedImages/IMAG1645.jpg

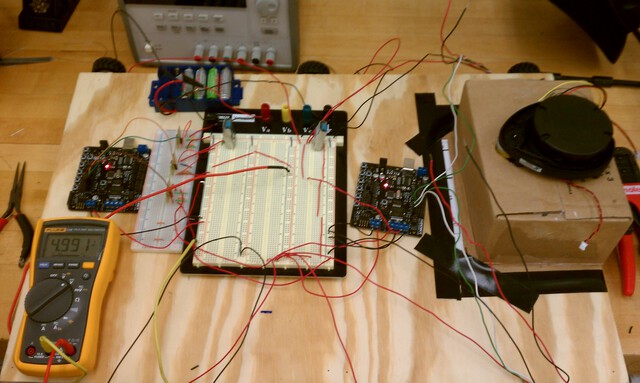
Documentation/SharedImages/IMAG1645.jpg
