farzonl/gtnr/Documentation/SharedImages/IMAG1682.jpg

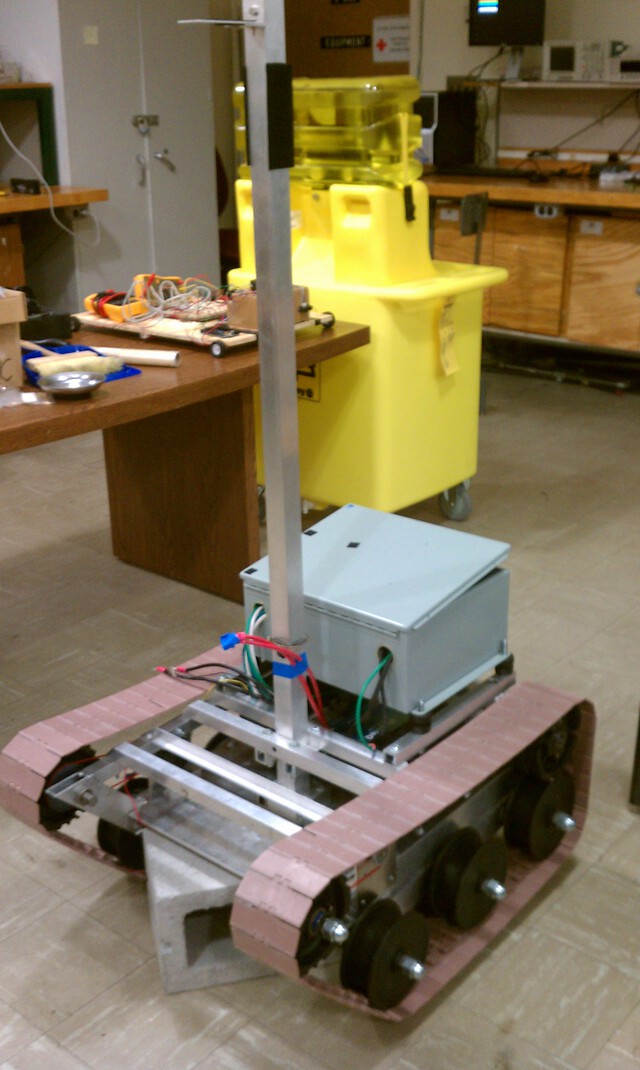
Documentation/SharedImages/IMAG1682.jpg
