farzonl/gtnr/Documentation/SharedImages/IMAG1683.jpg

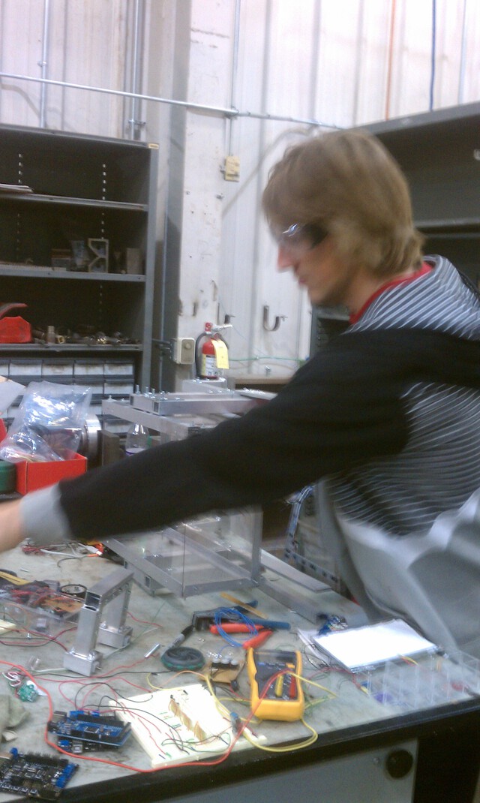
Documentation/SharedImages/IMAG1683.jpg
