farzonl/gtnr/Documentation/SharedImages/IMAG1684.jpg

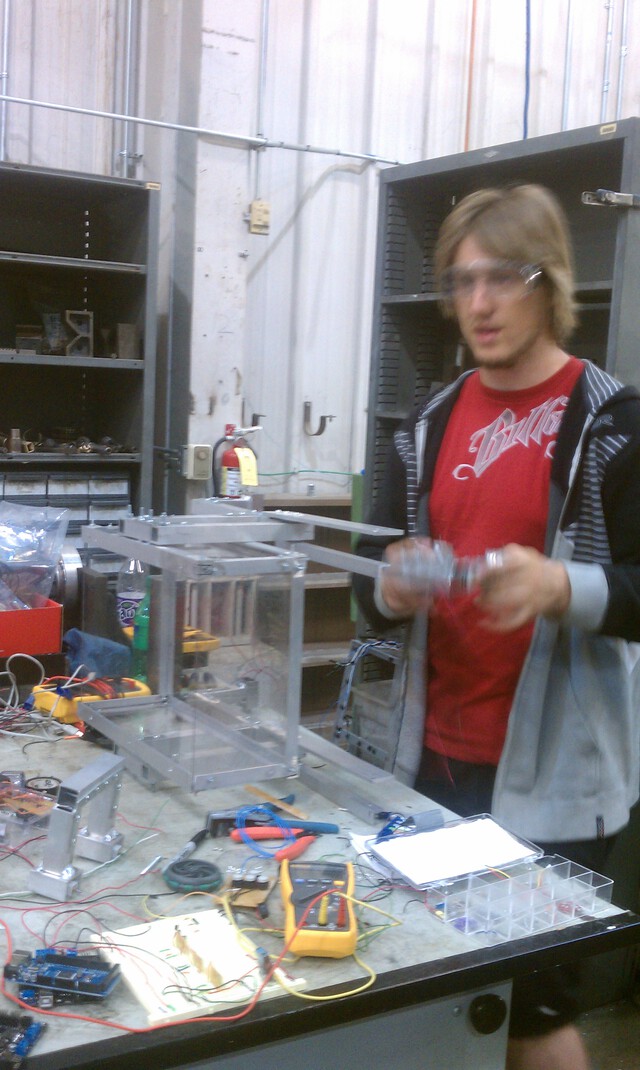
Documentation/SharedImages/IMAG1684.jpg
