farzonl/gtnr/Documentation/SharedImages/IMAG1685.jpg

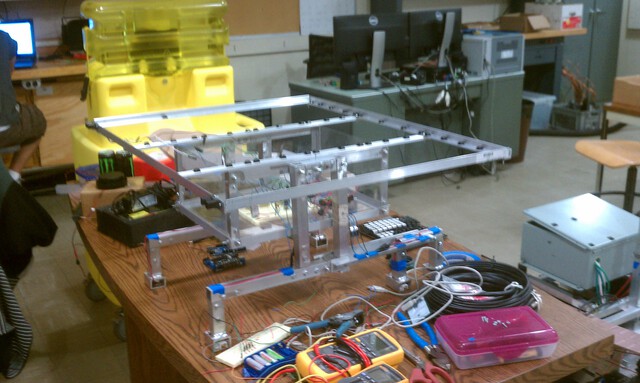
Documentation/SharedImages/IMAG1685.jpg
