farzonl/gtnr/Documentation/SharedImages/IMAG1698.jpg

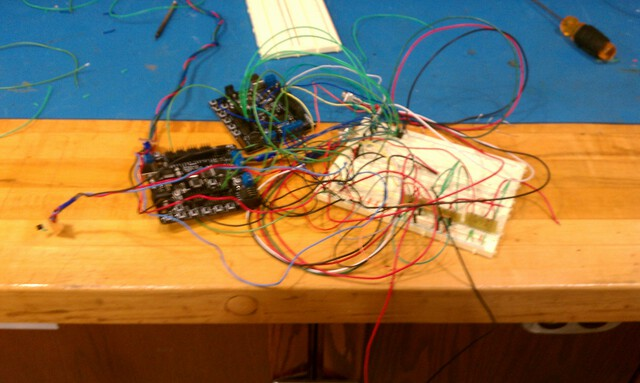
Documentation/SharedImages/IMAG1698.jpg
