farzonl/gtnr/Documentation/SharedImages/IMAG1699.jpg

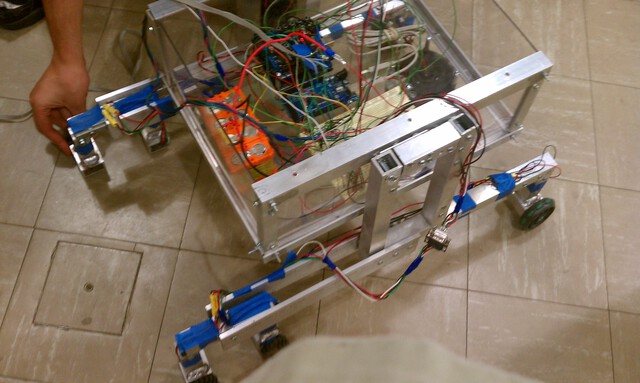
Documentation/SharedImages/IMAG1699.jpg
