farzonl/gtnr/Documentation/SharedImages/IMAG1700.jpg

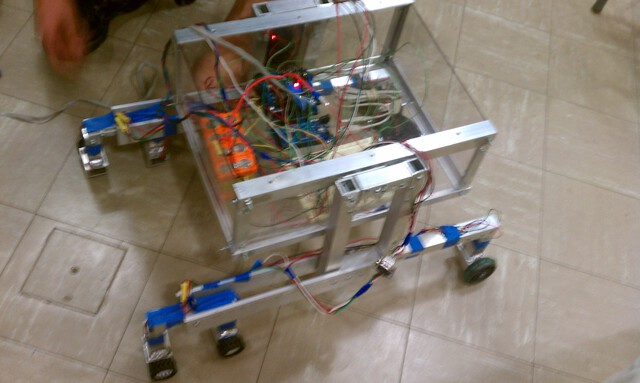
Documentation/SharedImages/IMAG1700.jpg
