farzonl/gtnr/Documentation/SharedImages/IMAG1701.jpg

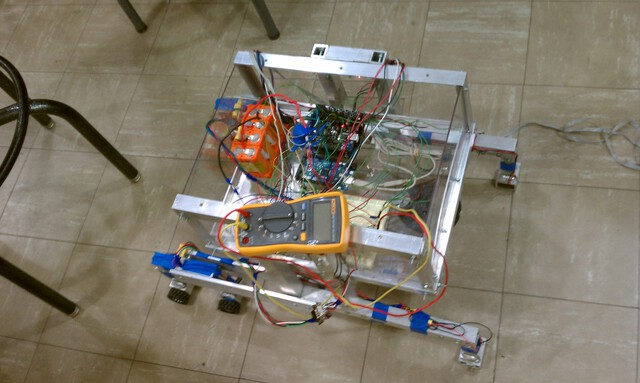
Documentation/SharedImages/IMAG1701.jpg
