farzonl/gtnr/Documentation/SharedImages/IMAG1702.jpg

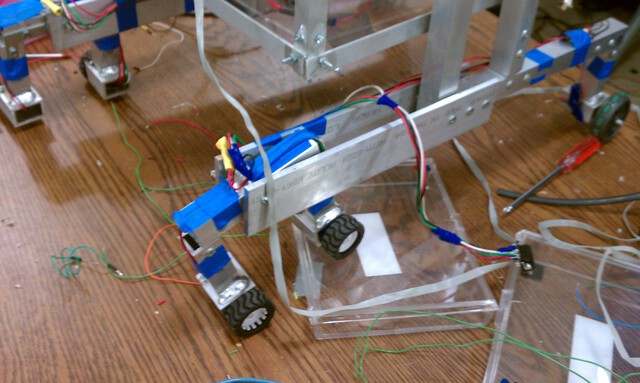
Documentation/SharedImages/IMAG1702.jpg
