farzonl/gtnr/Documentation/SharedImages/IMAG1703.jpg

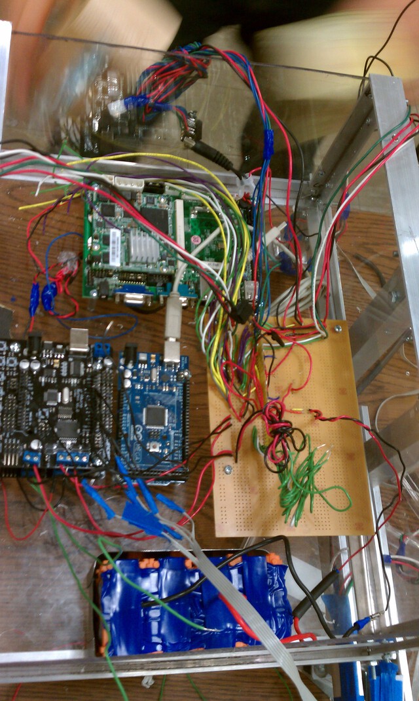
Documentation/SharedImages/IMAG1703.jpg
