farzonl/gtnr/Documentation/SharedImages/IMAG1711.jpg

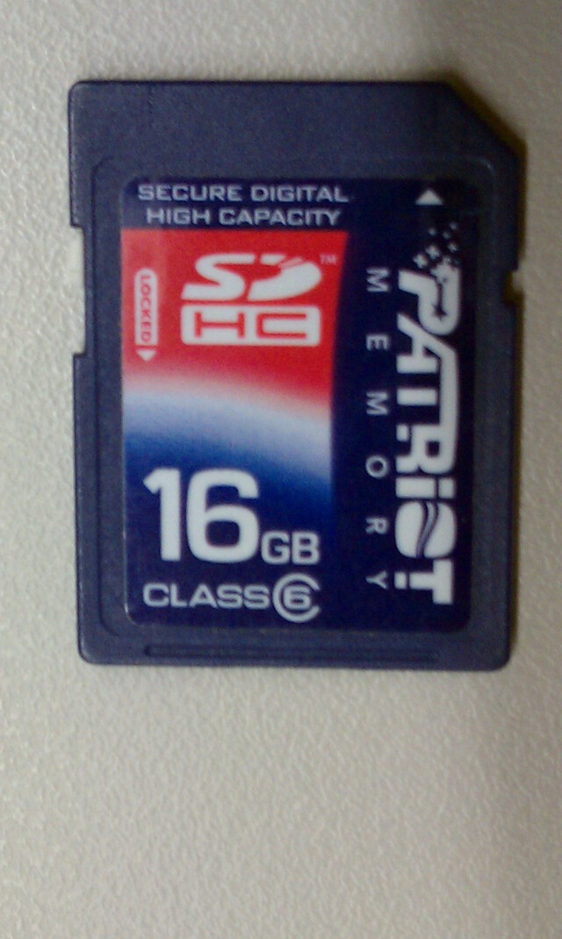
Documentation/SharedImages/IMAG1711.jpg
