farzonl/gtnr/Documentation/SharedImages/IMAG1712.jpg

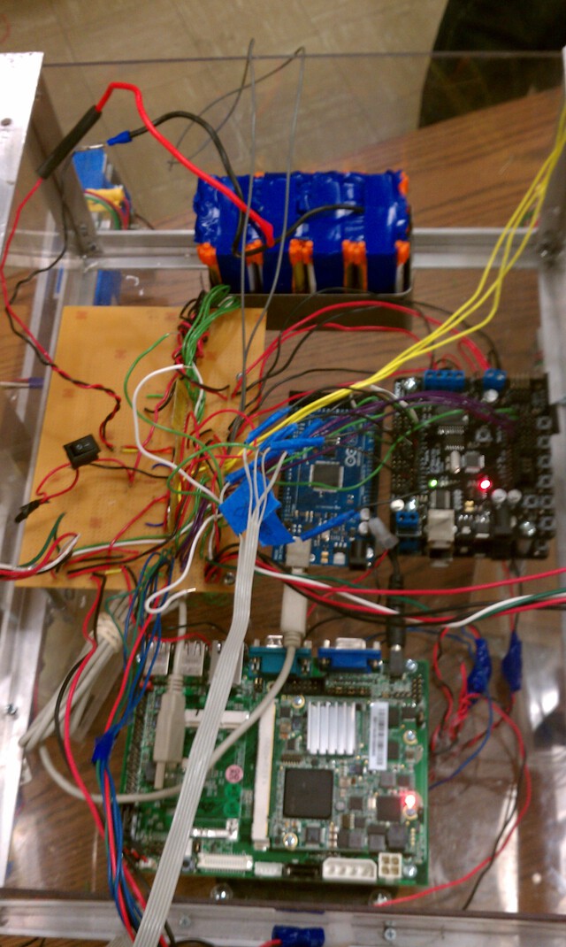
Documentation/SharedImages/IMAG1712.jpg
