farzonl/gtnr/Documentation/SharedImages/IMAG1713.jpg

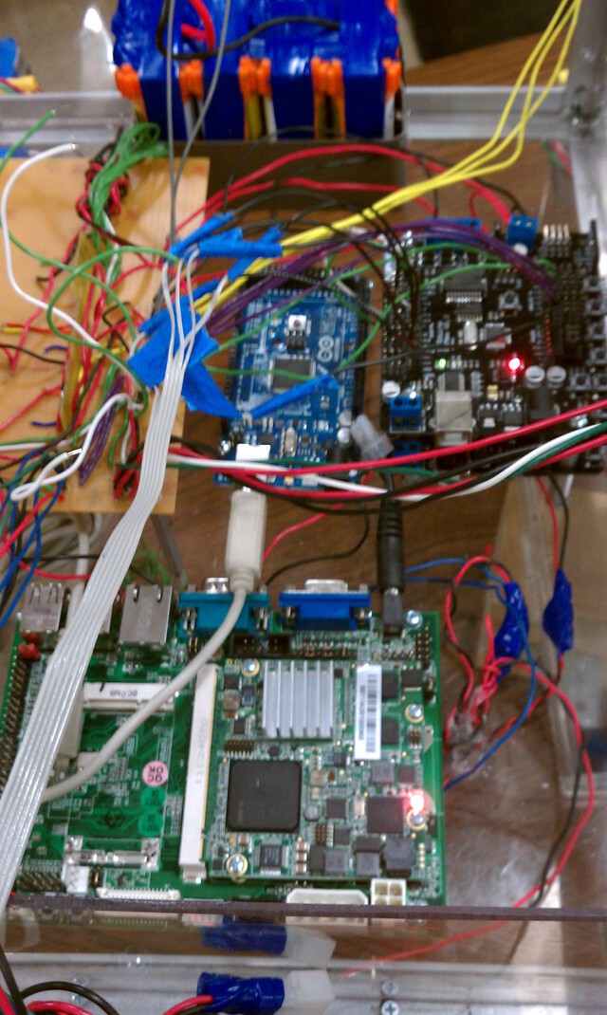
Documentation/SharedImages/IMAG1713.jpg
