farzonl/gtnr/Documentation/SharedImages/IMAG1714.jpg

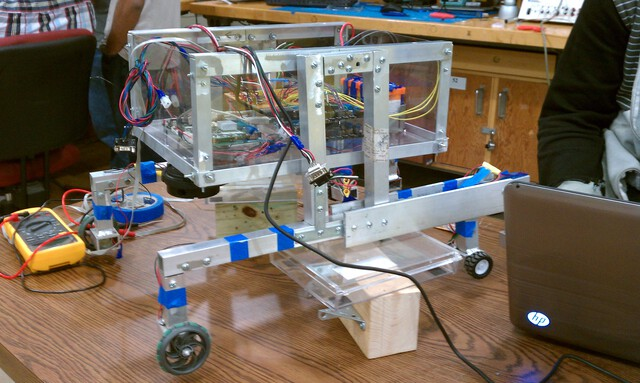
Documentation/SharedImages/IMAG1714.jpg
