farzonl/gtnr/Documentation/SharedImages/IMAG1719.jpg

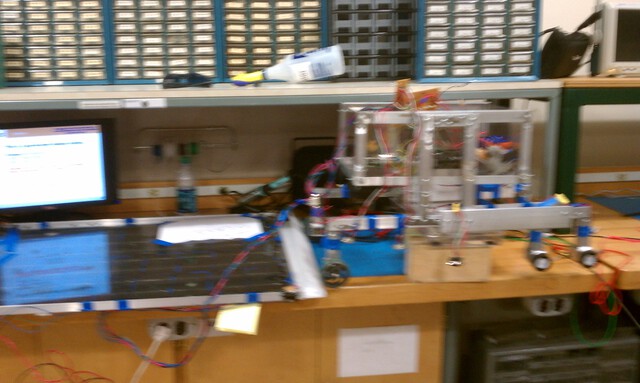
Documentation/SharedImages/IMAG1719.jpg
