farzonl/gtnr/Documentation/SharedImages/IMAG1720.jpg

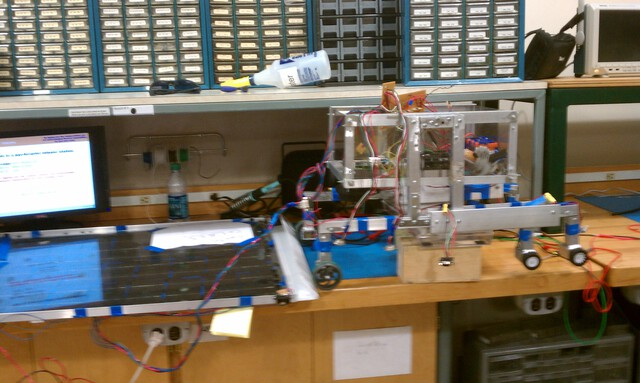
Documentation/SharedImages/IMAG1720.jpg
