farzonl/gtnr/Documentation/SharedImages/solarPanel.png

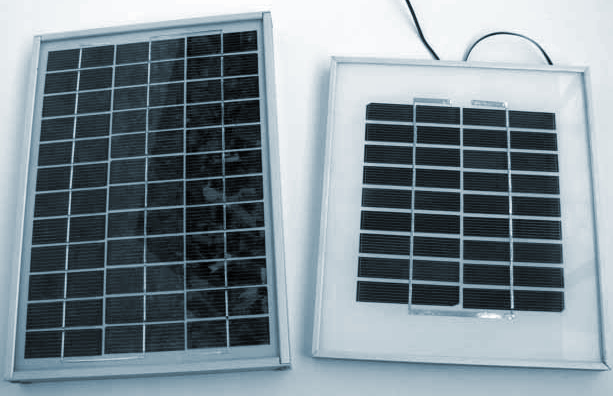
Documentation/SharedImages/solarPanel.png
