farzonl/gtnr/(list of files, cad)

Other CAD files:
Documentation/FinalReport/StructureCAD/rockerDrawings.SLDDRW
