farzonl/gtnr/Documentation/FinalReport/StructureCAD/Mechanical/Short_GTNR_View_16x12x6.PDF

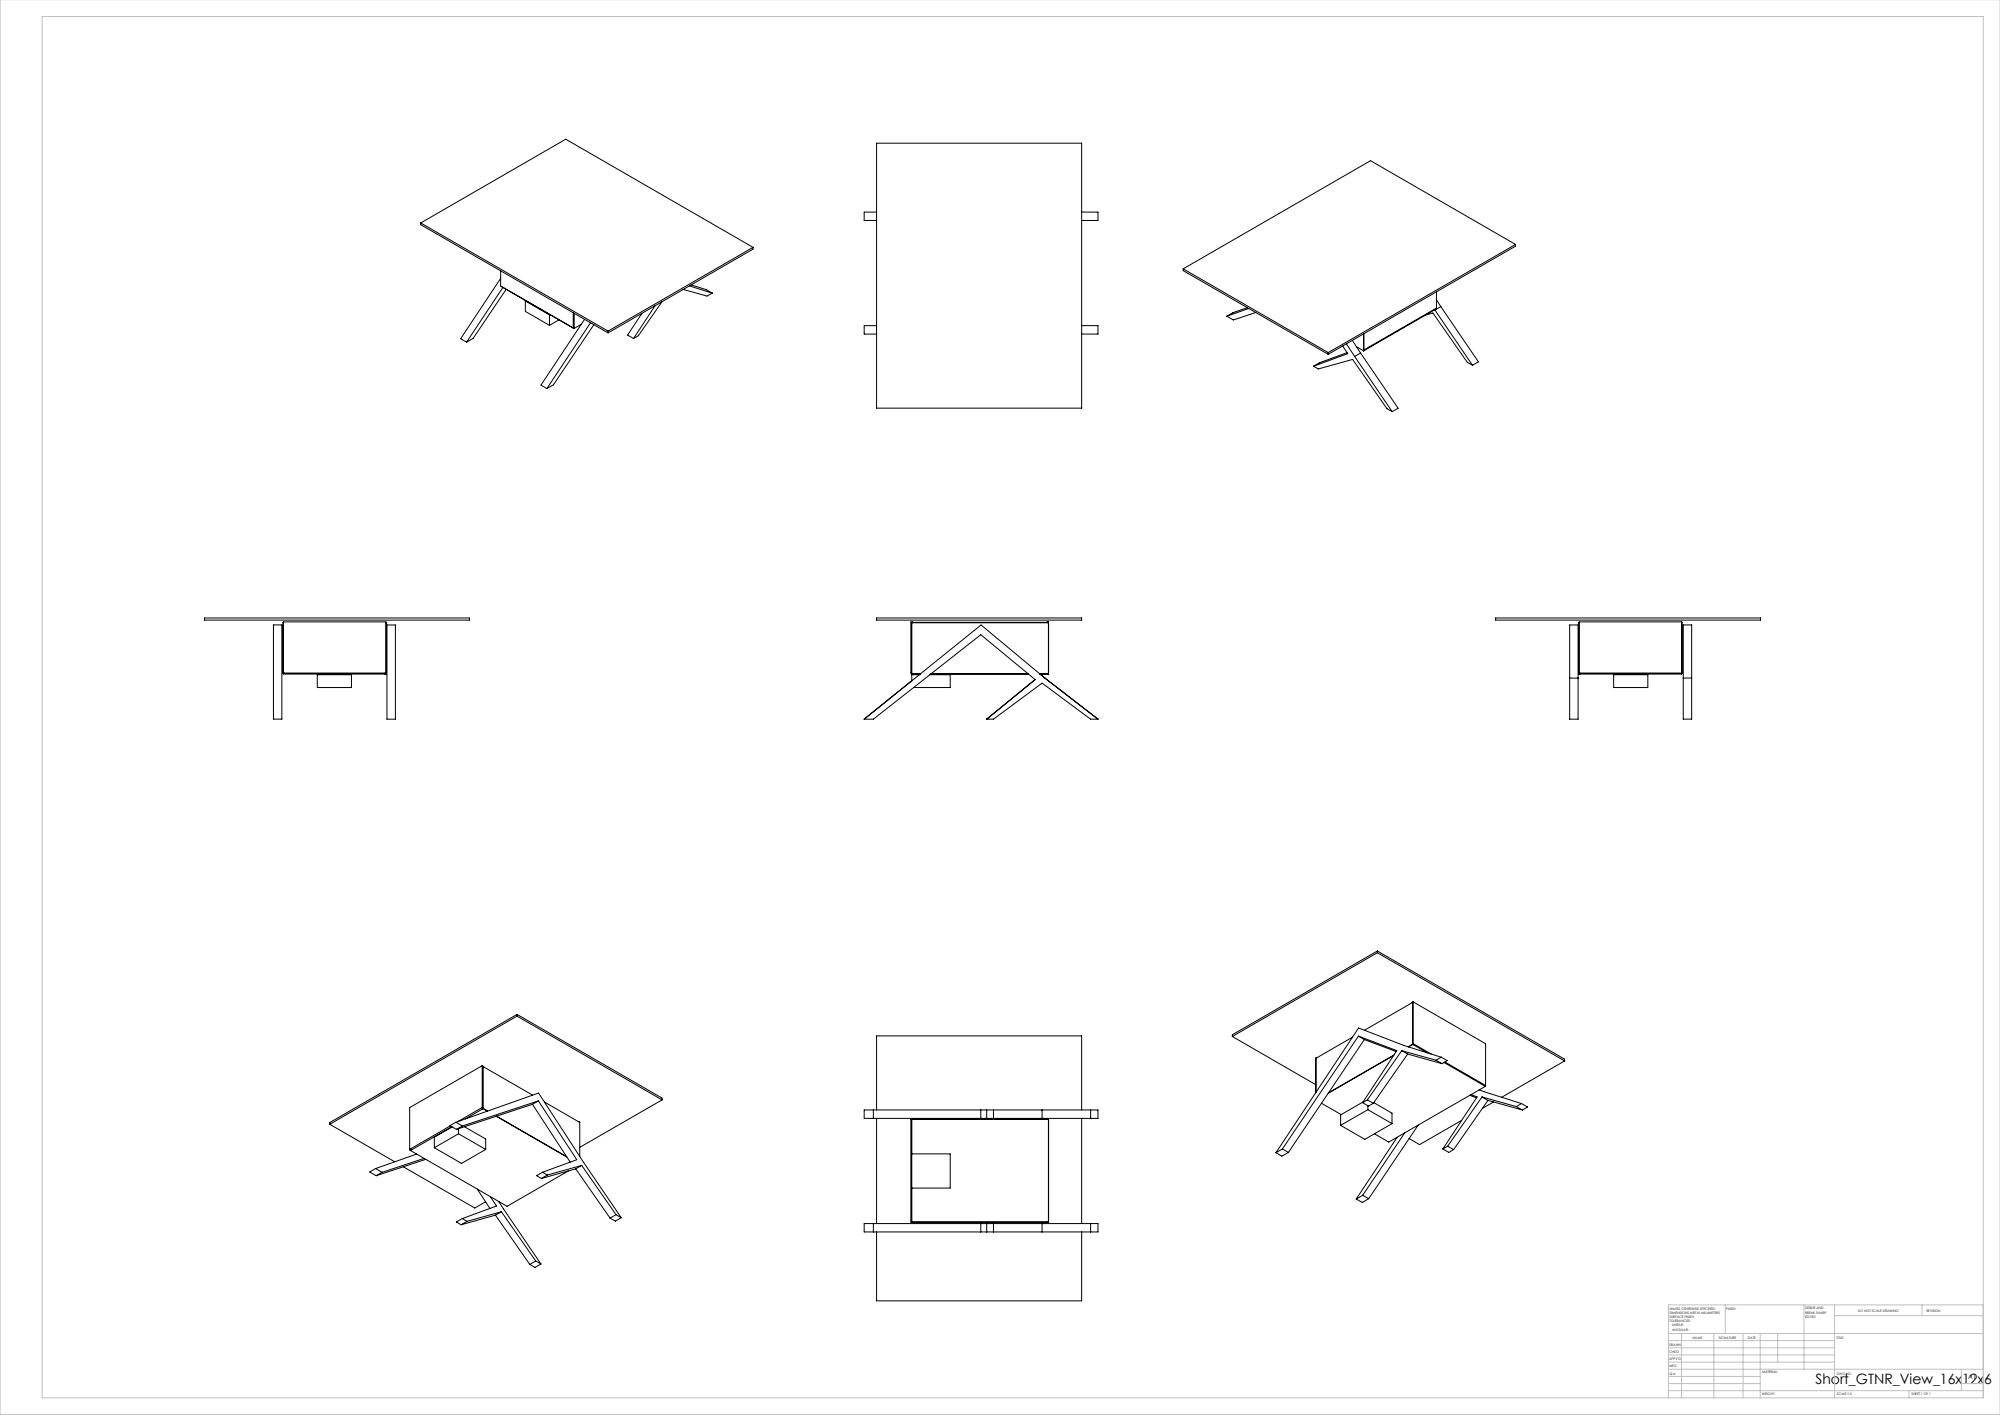
[picture p260: page 1]
SCALE:1:5; SHEET 1 OF 1; DO NOT SCALE DRAWING; REVISION; DEBUR AND BREAK SHARP; UNLESS OTHERWISE SPECIFIED:; FINISH:

DIMENSIONS ARE IN MILLIMETERS
SURFACE FINISH:
TOLERANCES:
LINEAR:
ANGULAR:

NAME | SIGNATURE | DATE | | | | TITLE:
Q.A | | | | MATERIAL: Short_GTNR_View_16x12x6 WEIGHT: | DWG NO. | A1

DRAWN
CHK'D
APPV'D
MFG
