farzonl/gtnr/Arduino/GTNR_Battery_Controller/GTNR_Battery_Controller.h

#ifndef GTNR_Batter_Controller_h
#define GTNR_Battery_Controller_h

#define GTNR_5V      0
#define GTNR_12V     1
#define GTNR_Motors  2
#define GTNR_5V_Pin      0
#define GTNR_12V_Pin     1
#define GTNR_Motors_Pin  2

// Define Temperature keywords
#define BODY  0
#define ATOM  1
#define BATT  2
#define BODY_Pin  3
#define ATOM_Pin  4
#define BATT_Pin  5


void handle_current(void);
void handle_temperature(void);

#endif
