farzonl/gtnr/(commit log)

2012-02-24 Initial Commit. Includes Java visualization from serial lidar output and proof of concept sketches for arduino
2012-02-29 Adding bug fixes to the Java Visualizer. All minor changes.
    [Main.java]
2012-02-29 Adding Arduino source code.
2012-03-08 Working Serial Library tested with Lidar simulation data sketch on Arduino Mega and HP Laptop running Kubuntu 11.10. Small bug fixes to visualization library.
    [Main.java]
2012-03-17 Started motor controller sketch. Broke most functionality into libraries. TODO: implement sensor functions.
    [DFRduino_KeyLib.c, GTNR_Motor_Controller.h, GTNR_Motor_Controller.ino]
2012-03-22 Adding battery controller sketch. Commiting tested functionality for Motor Controller: Photocells and IR Senors, Battery Controller: Temperature Sensors
2012-03-23 Added current sensing functionality. All sensors are tested (in the lab) and functional, lidar is noisy. Power budget updated with experimental values. Schematic needs to be redone.
2012-03-23 Currently functioning visualization program. Experimental dump data is in Dropbox->pathplanning->lidar_test->
2012-03-23 Adding Lidar package for visualizer.
2012-04-02 Adding library dependencies { Encoder }.
2012-04-07 I changed up a bit of the graph functionality, not noticable change. Also added robust multithreaded network protoccol to communicate with and monitor the atom board
2012-04-10 sample code
2012-04-10 lidar integration not tested
2012-04-17 Adding Lidar driver sketch for debugging/testing programs with lidar data. Proof of concept of speed control.
2012-04-17 Adding lidar speed control functionality.
2012-04-21 writes a path in byte[] form to arduinos
2012-04-28 Fixed path planning code.
    [Main.java]
2012-04-28 Java to Server to Client propagation of lidar distance readings function and tested.
2019-09-07 add visuals to repreent project
    [MotorCalculations.xls, SunEL_542012.csv, rockerDrawings.SLDDRW]
